cukier/Encoder/doc/atmega328p-pinout-4e8ab260.png

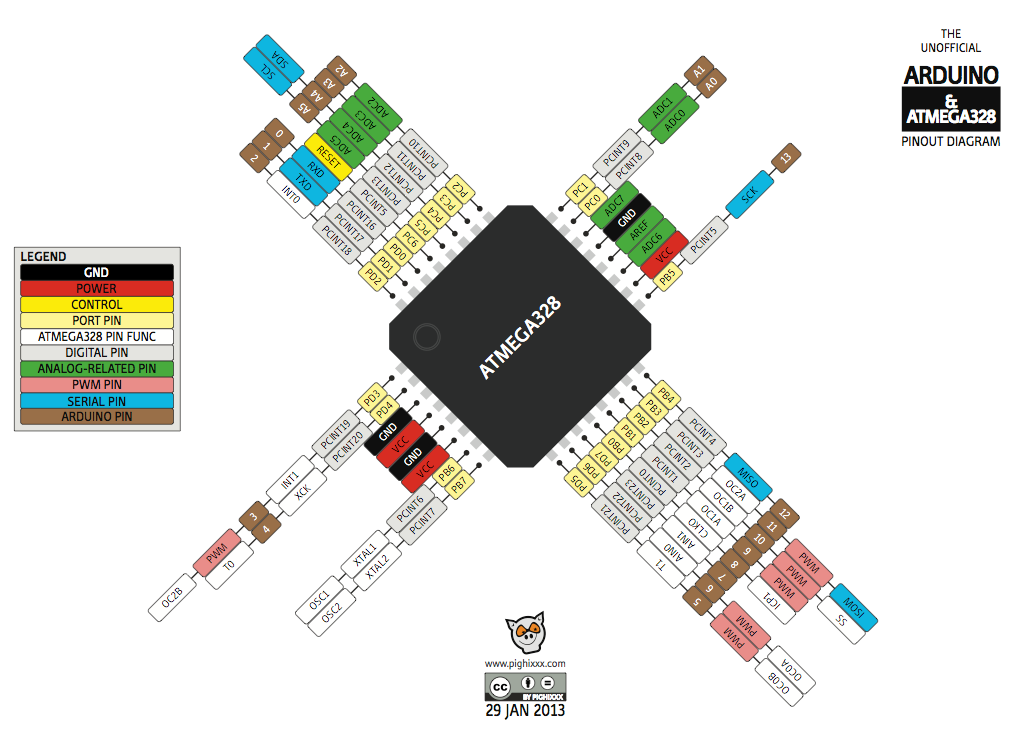
doc/atmega328p-pinout-4e8ab260.png
