cukier/Encoder/sch/atmel/pdf/encoder.pdf

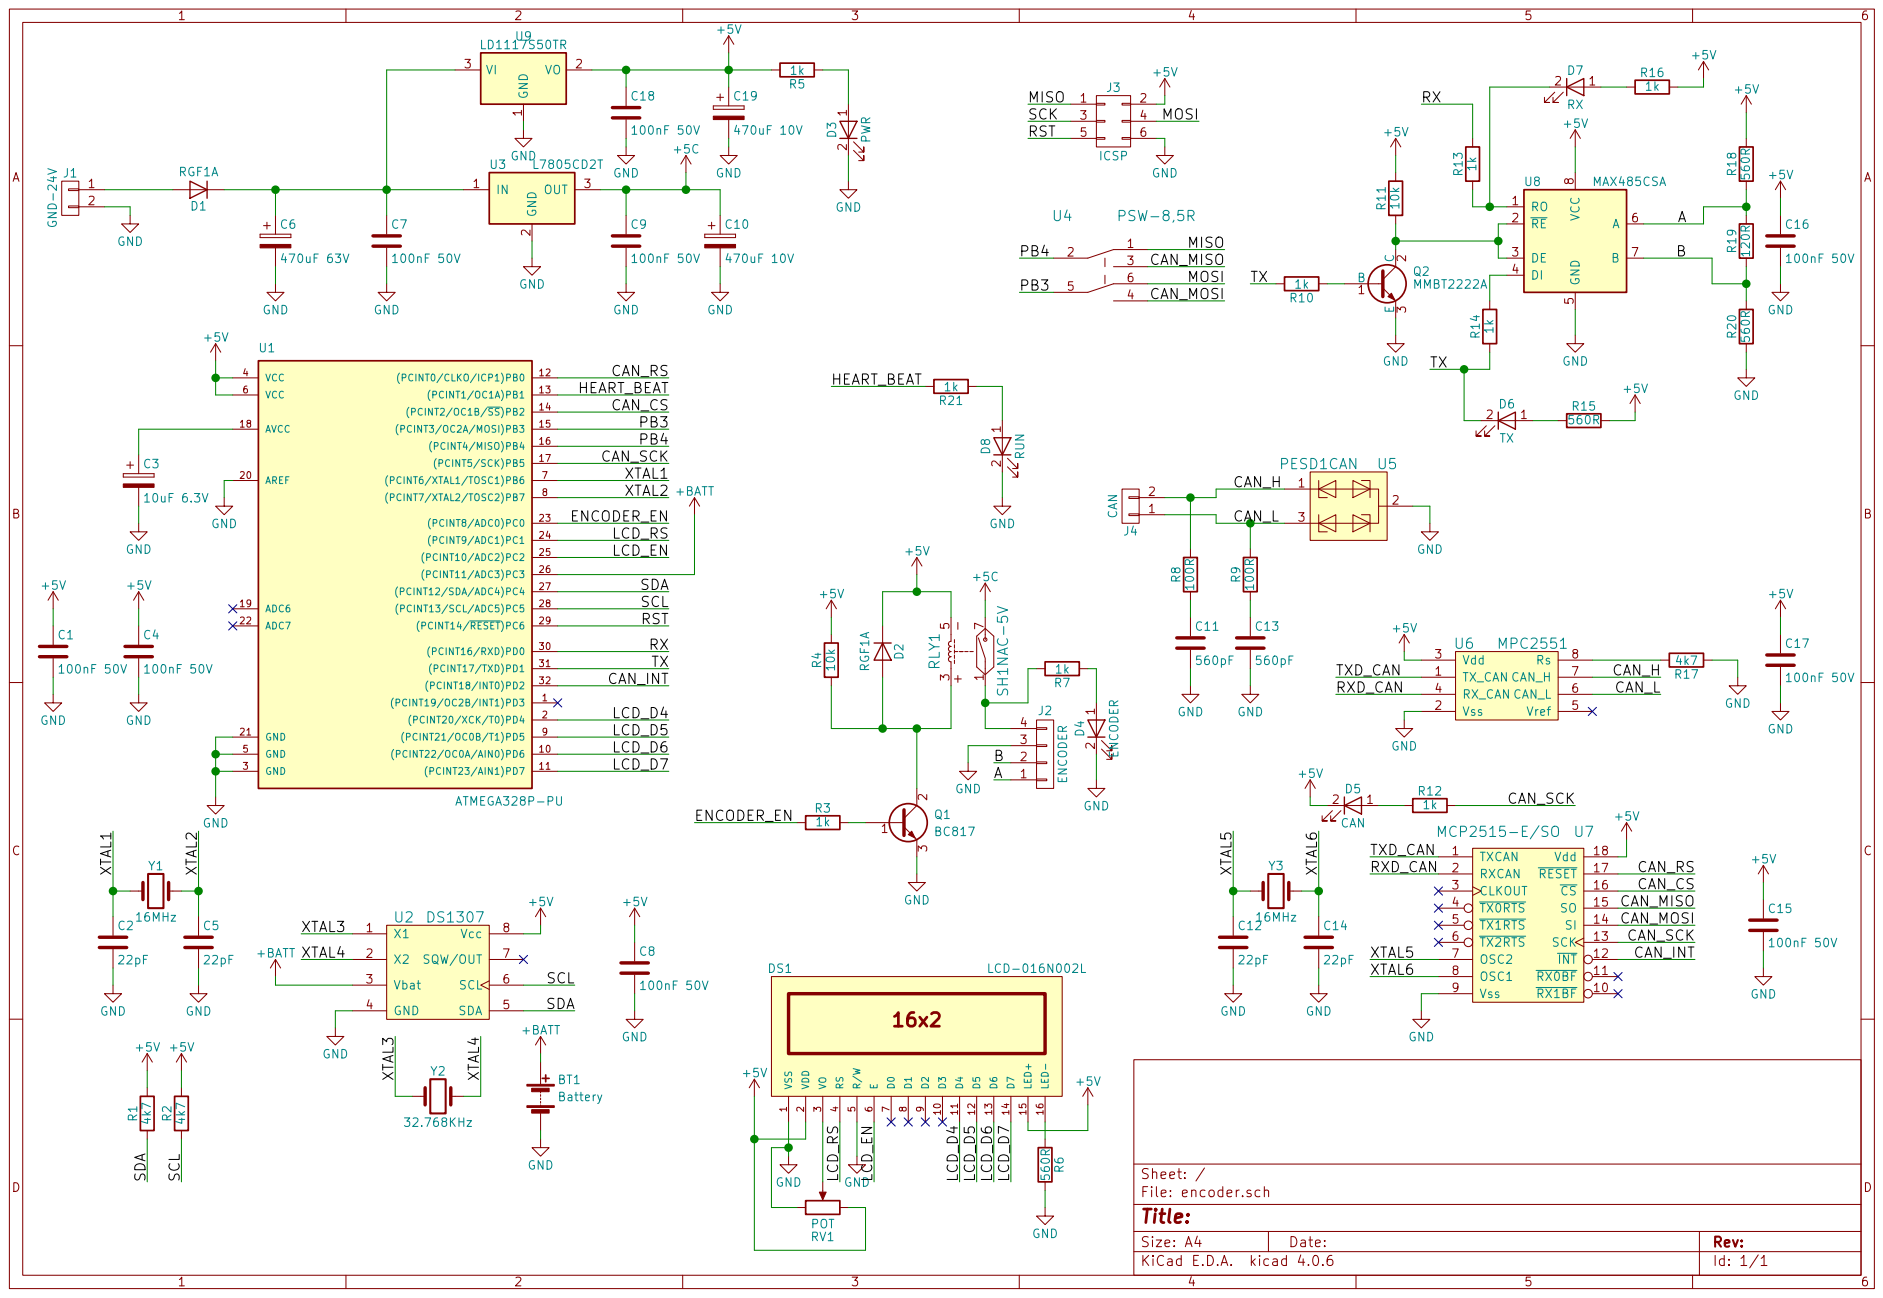
[picture p2: page 1]

9 D3 10 D4 11 D5 12 D6 13 D7 14 LED+ 15 LED- 16 DS1 LCD-016N002L GND

Id: 1/1 Title: File: encoder.sch Sheet: /
