cukier/Encoder/sch/microchip/doc/microchip-B.Cu.pdf

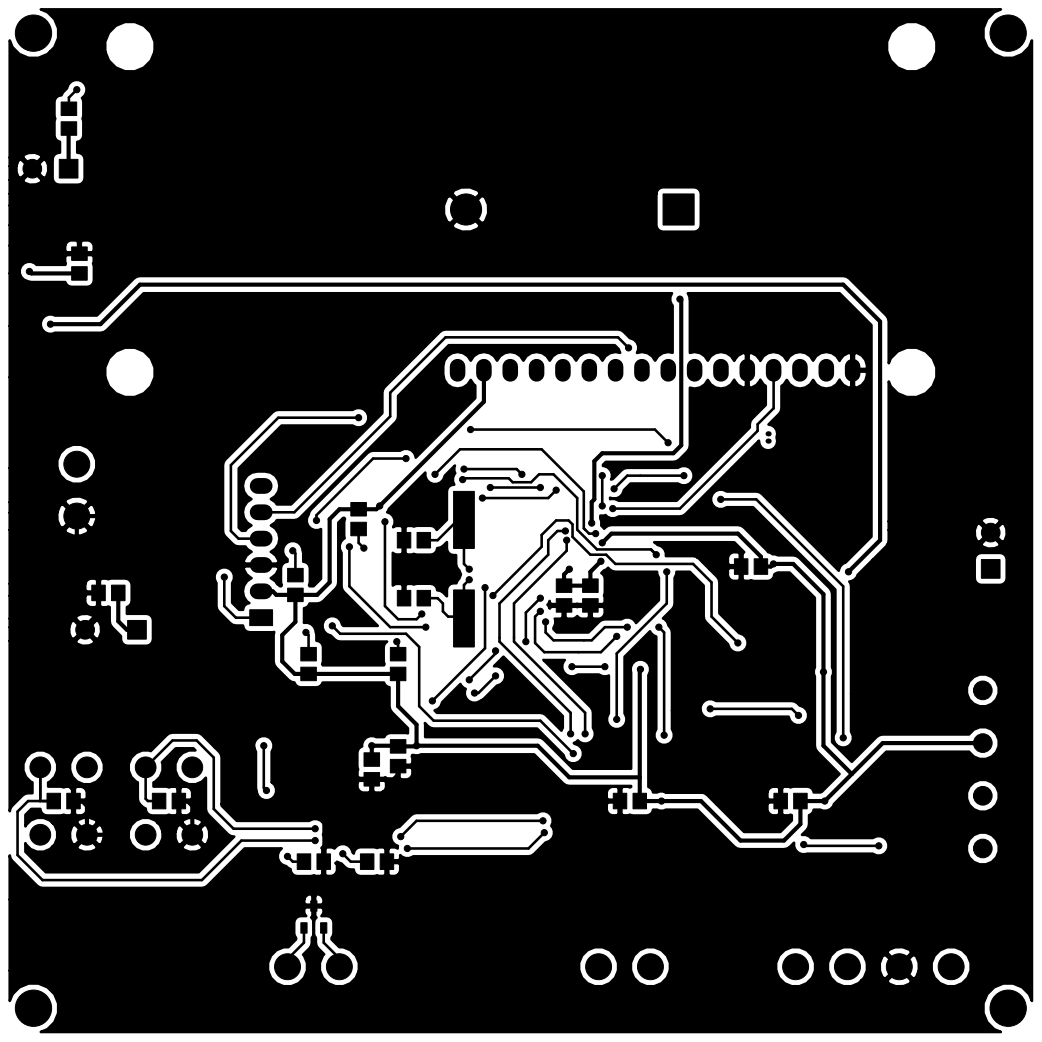
[picture p3: page 1]
