cukier/Encoder/sch/microchip/doc/microchip-B.Paste.pdf

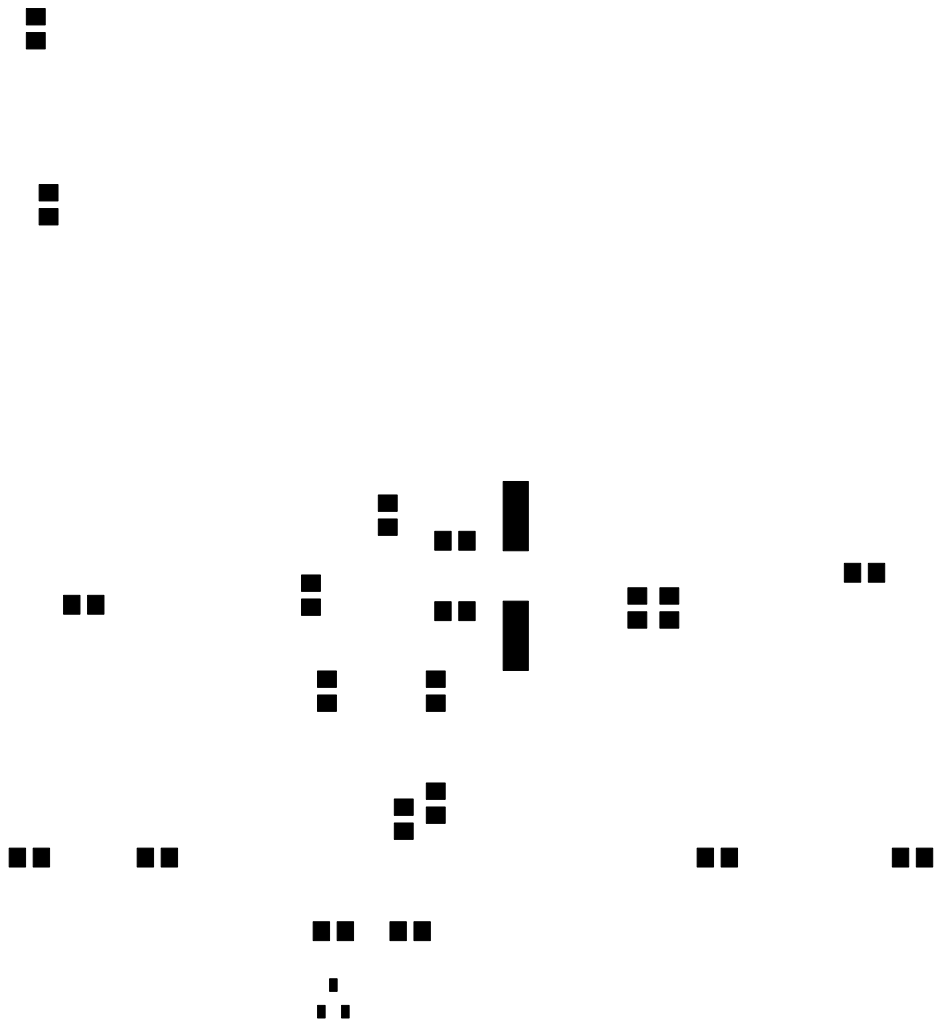
[picture p4: page 1]
