cukier/Encoder/sch/microchip/doc/microchip-B.SilkS.pdf

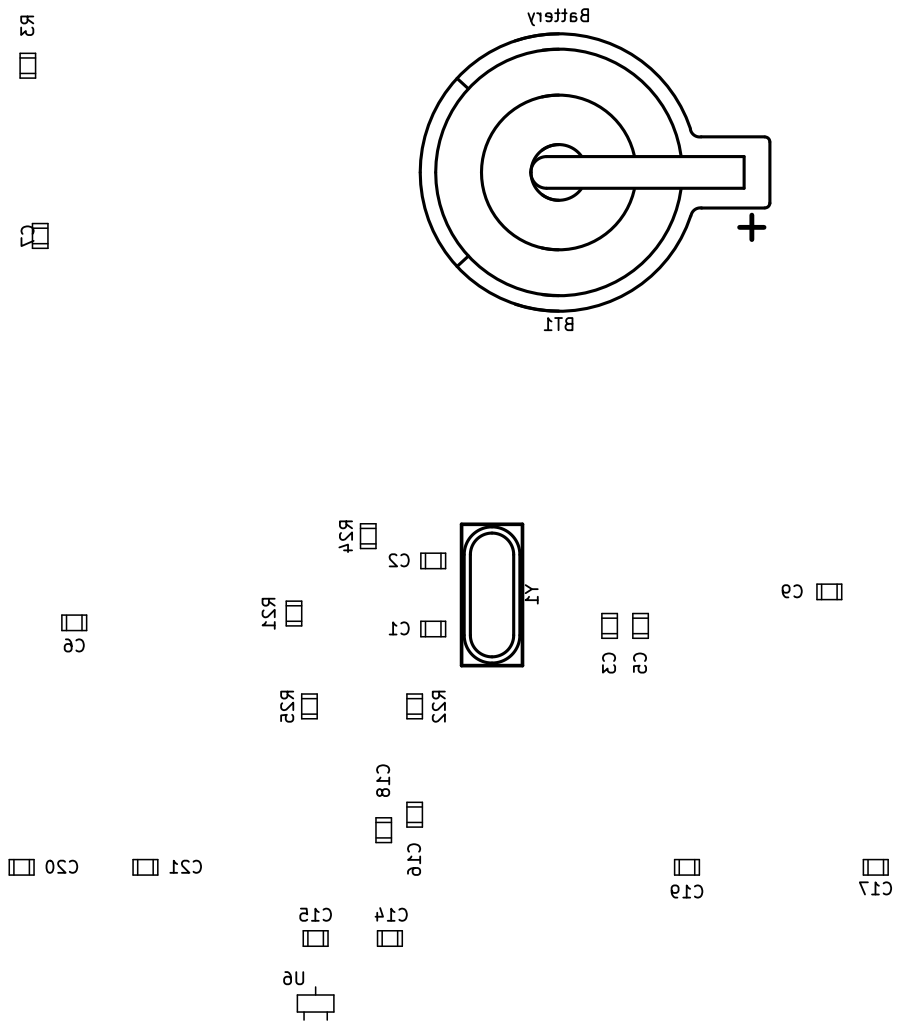
[picture p5: page 1]
