cukier/Encoder/sch/microchip/doc/microchip-F.Cu.pdf

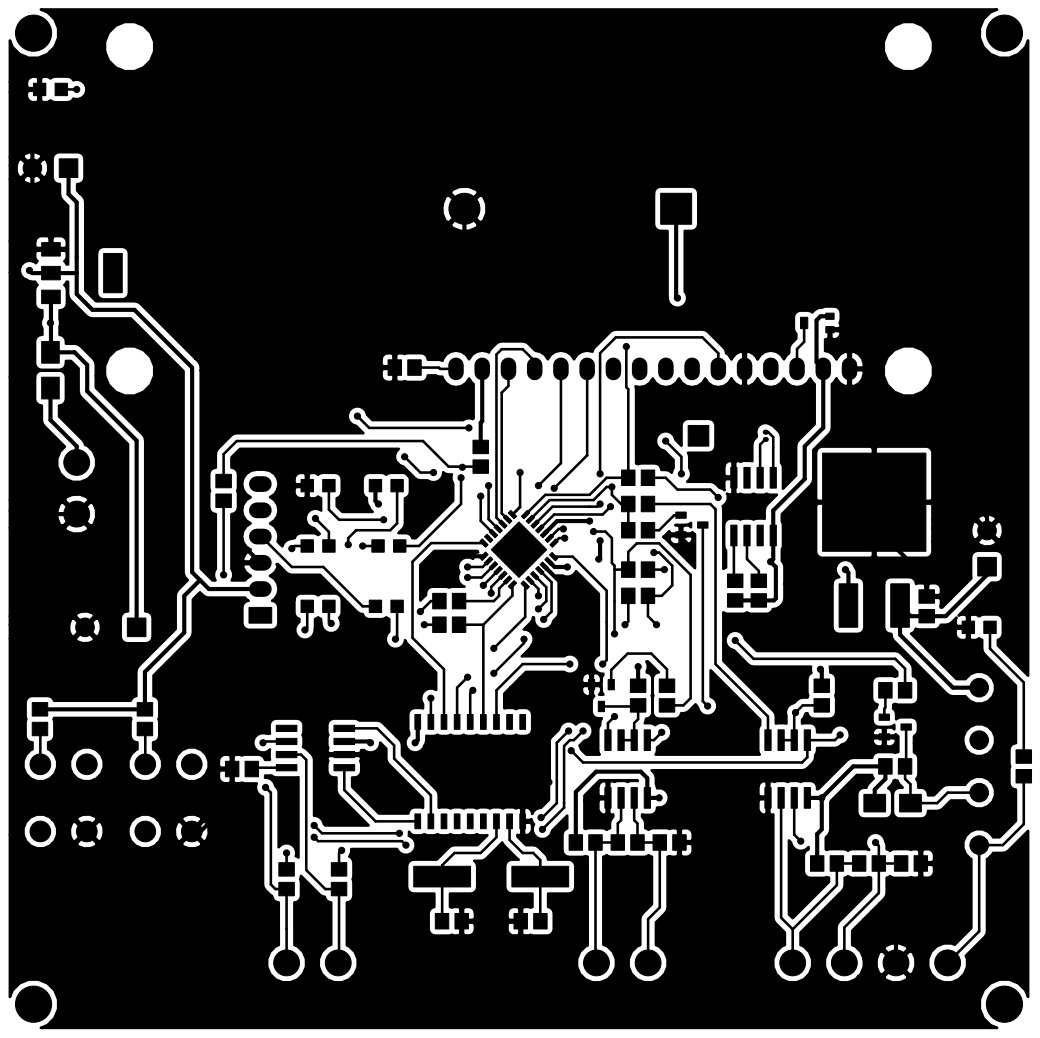
[picture p6: page 1]
