cukier/Encoder/sch/microchip/doc/microchip-F.Paste.pdf

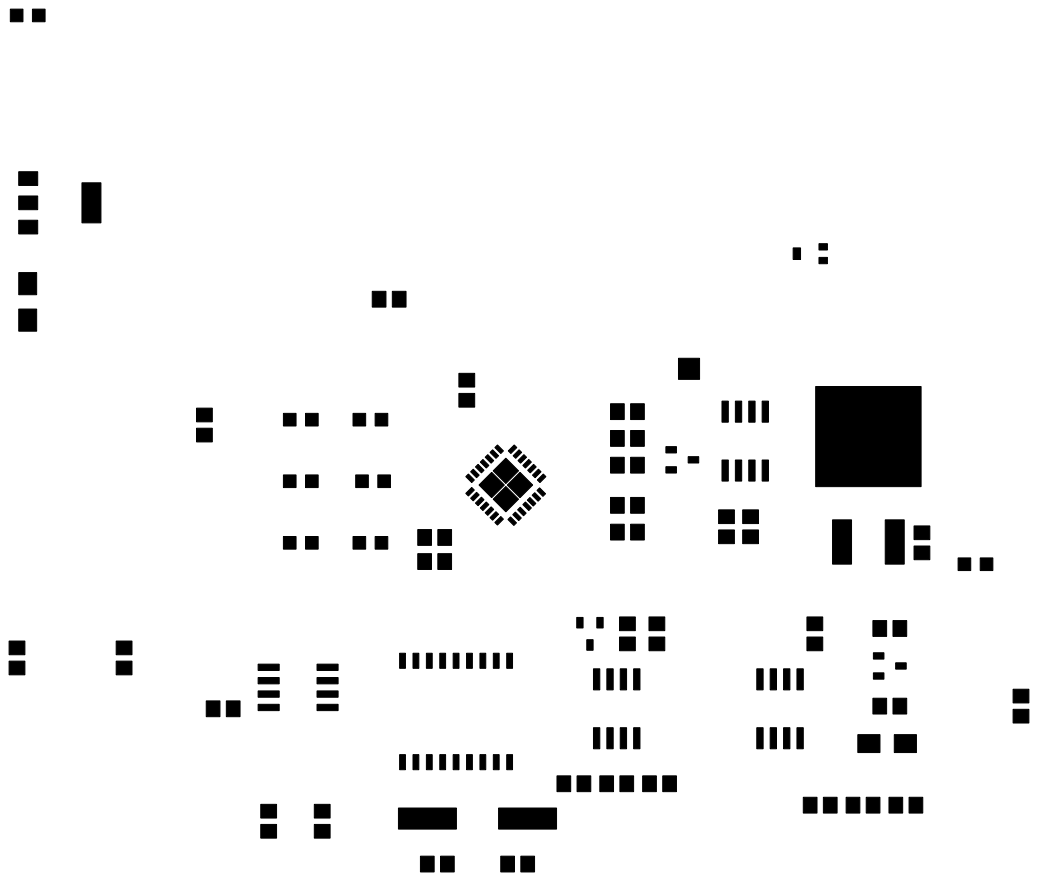
[picture p7: page 1]
