cukier/Encoder/sch/microchip/doc/microchip-F.SilkS.pdf

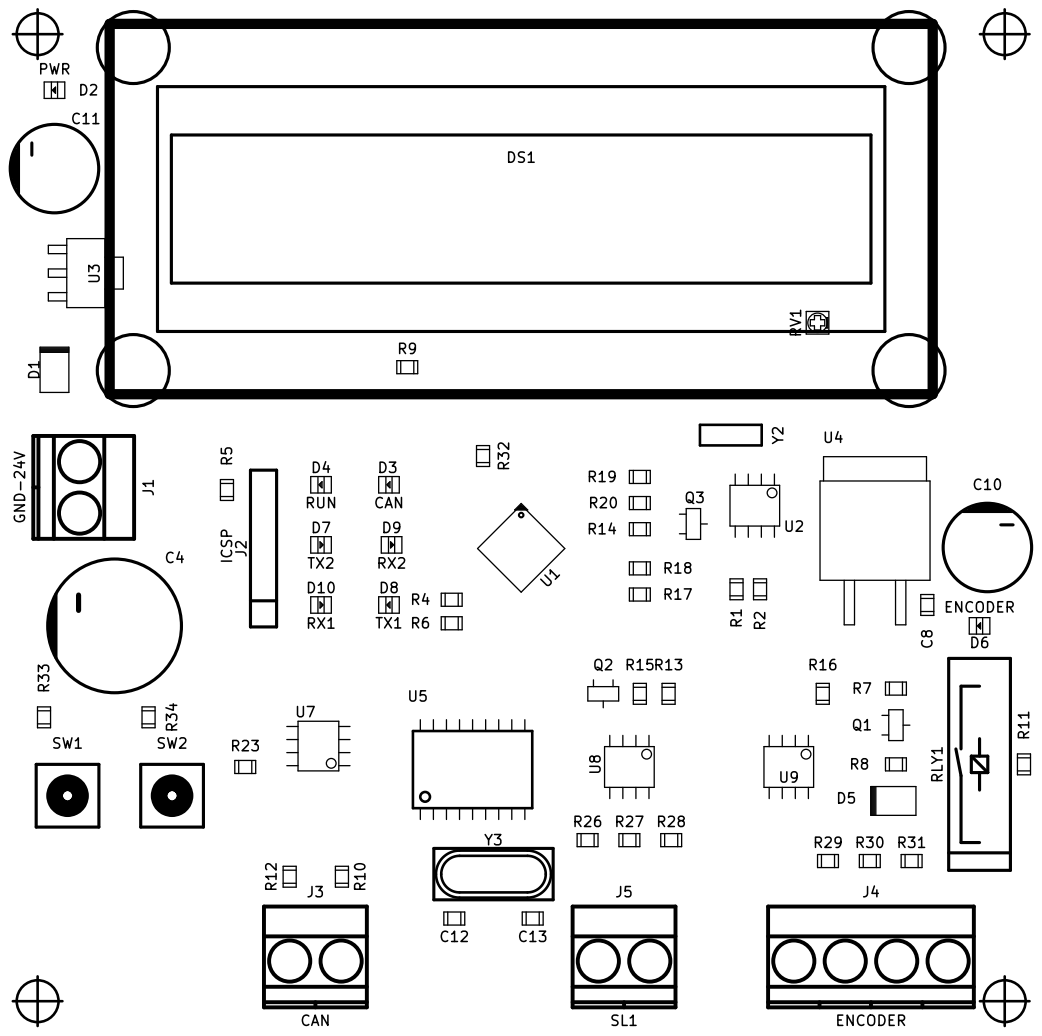
[picture p8: page 1]
