cukier/Encoder/sch/atmel/pdf/encoder-B.Cu.pdf

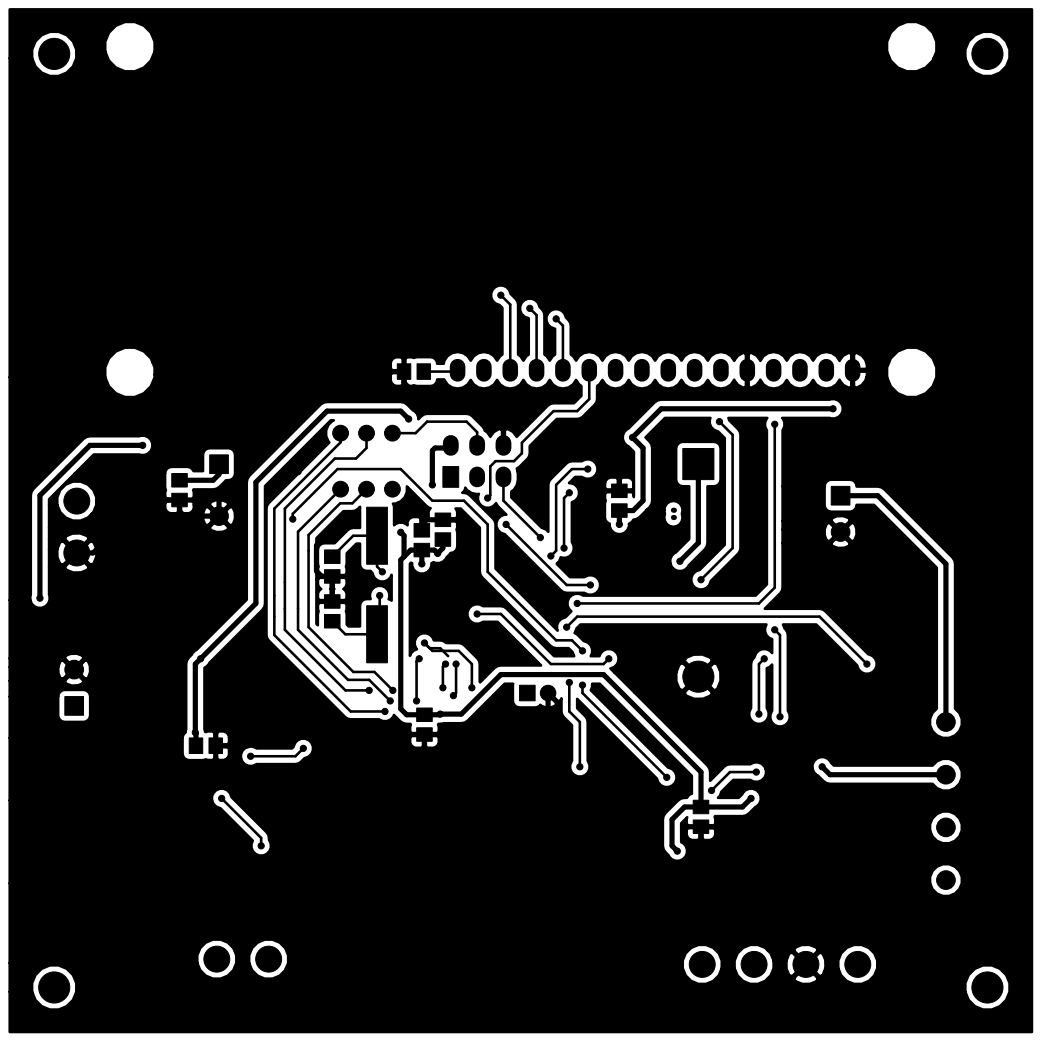
[picture p9: page 1]
