cukier/Encoder/sch/atmel/pdf/encoder-B.Mask.pdf

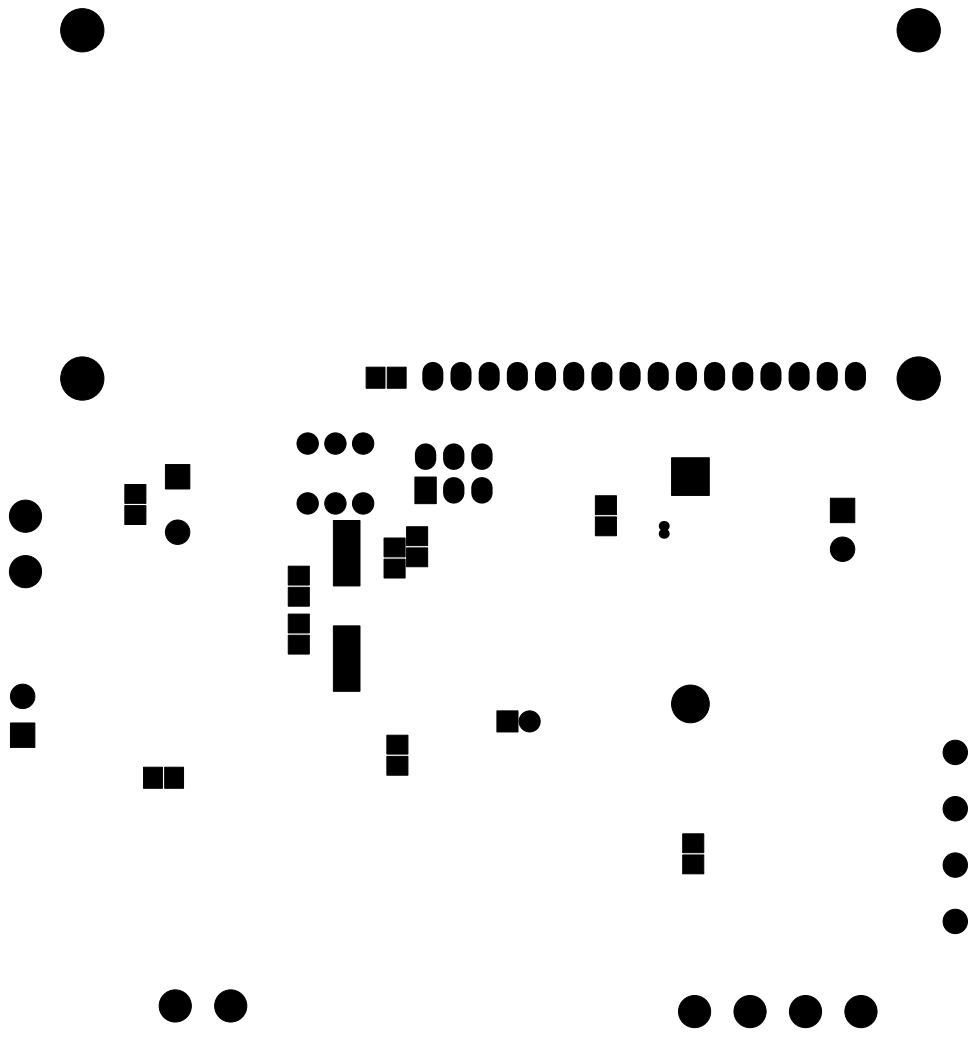
[picture p10: page 1]
