cukier/Encoder/sch/atmel/pdf/encoder-B.SilkS.pdf

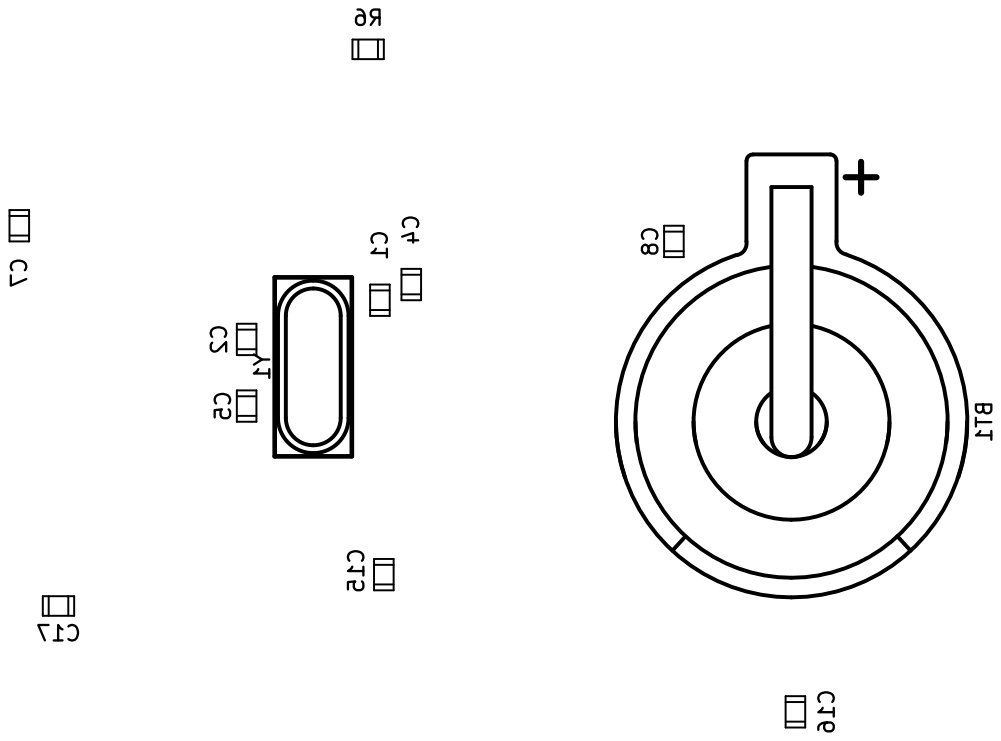
[picture p11: page 1]
