cukier/Encoder/sch/atmel/pdf/encoder-F.Cu.pdf

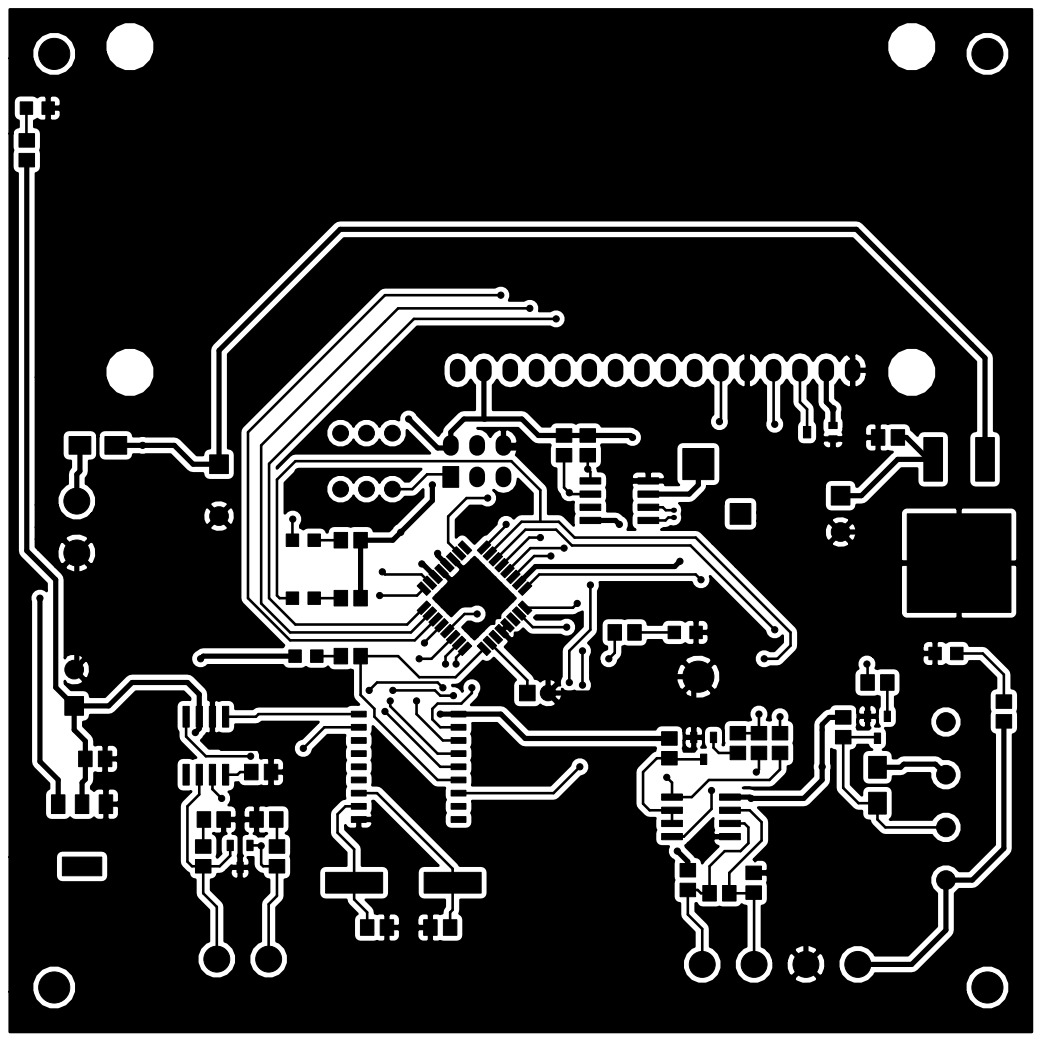
[picture p12: page 1]
