cukier/Encoder/sch/atmel/pdf/encoder-F.Mask.pdf

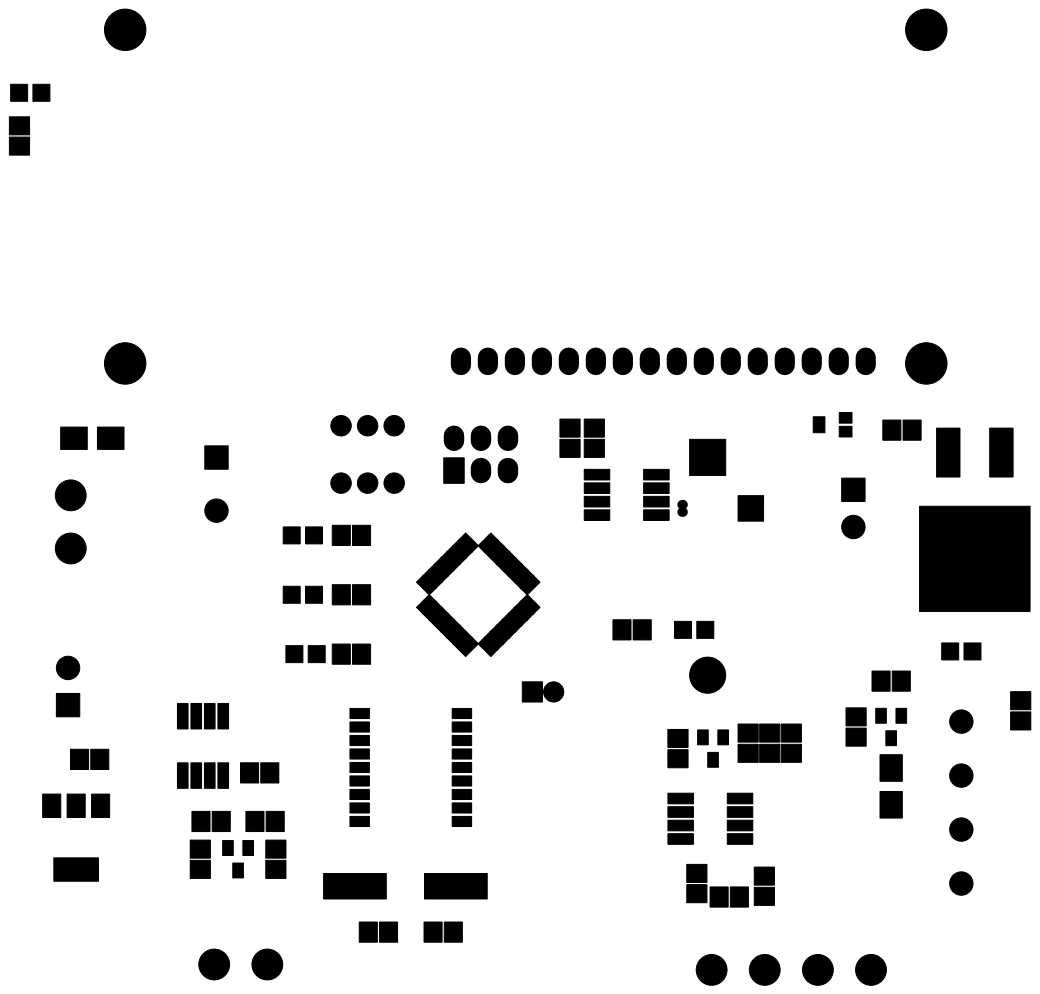
[picture p13: page 1]
