cukier/Encoder/sch/atmel/pdf/encoder-F.SilkS.pdf

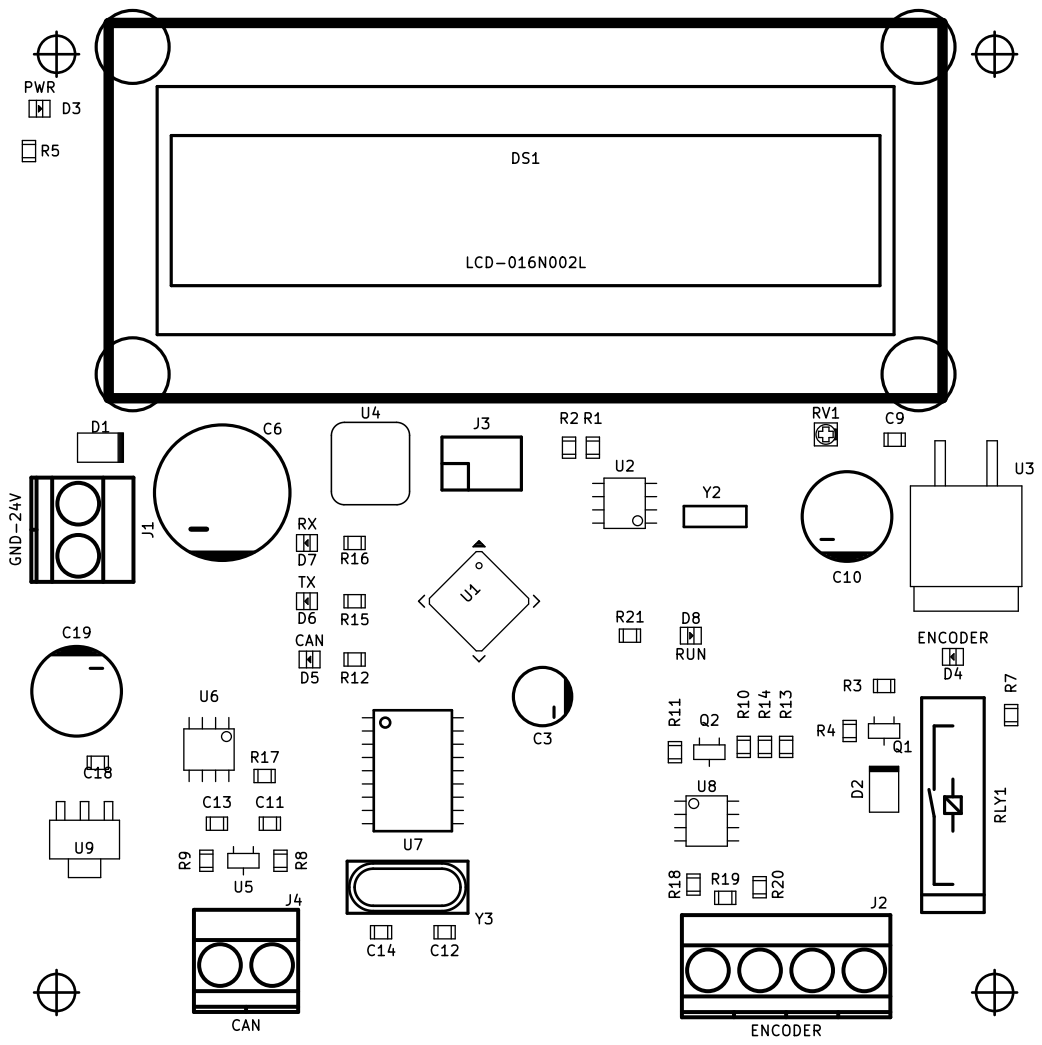
[picture p14: page 1]
