cukier/Encoder/(list of files, drawings)

Other design files:
sim/encoder.DSN
sim/encodera.DSN
