cukier/Encoder/sch/microchip/microchip.kicad_pcb

## KiCad design sch/microchip/microchip.kicad_pcb (2017-07-24)

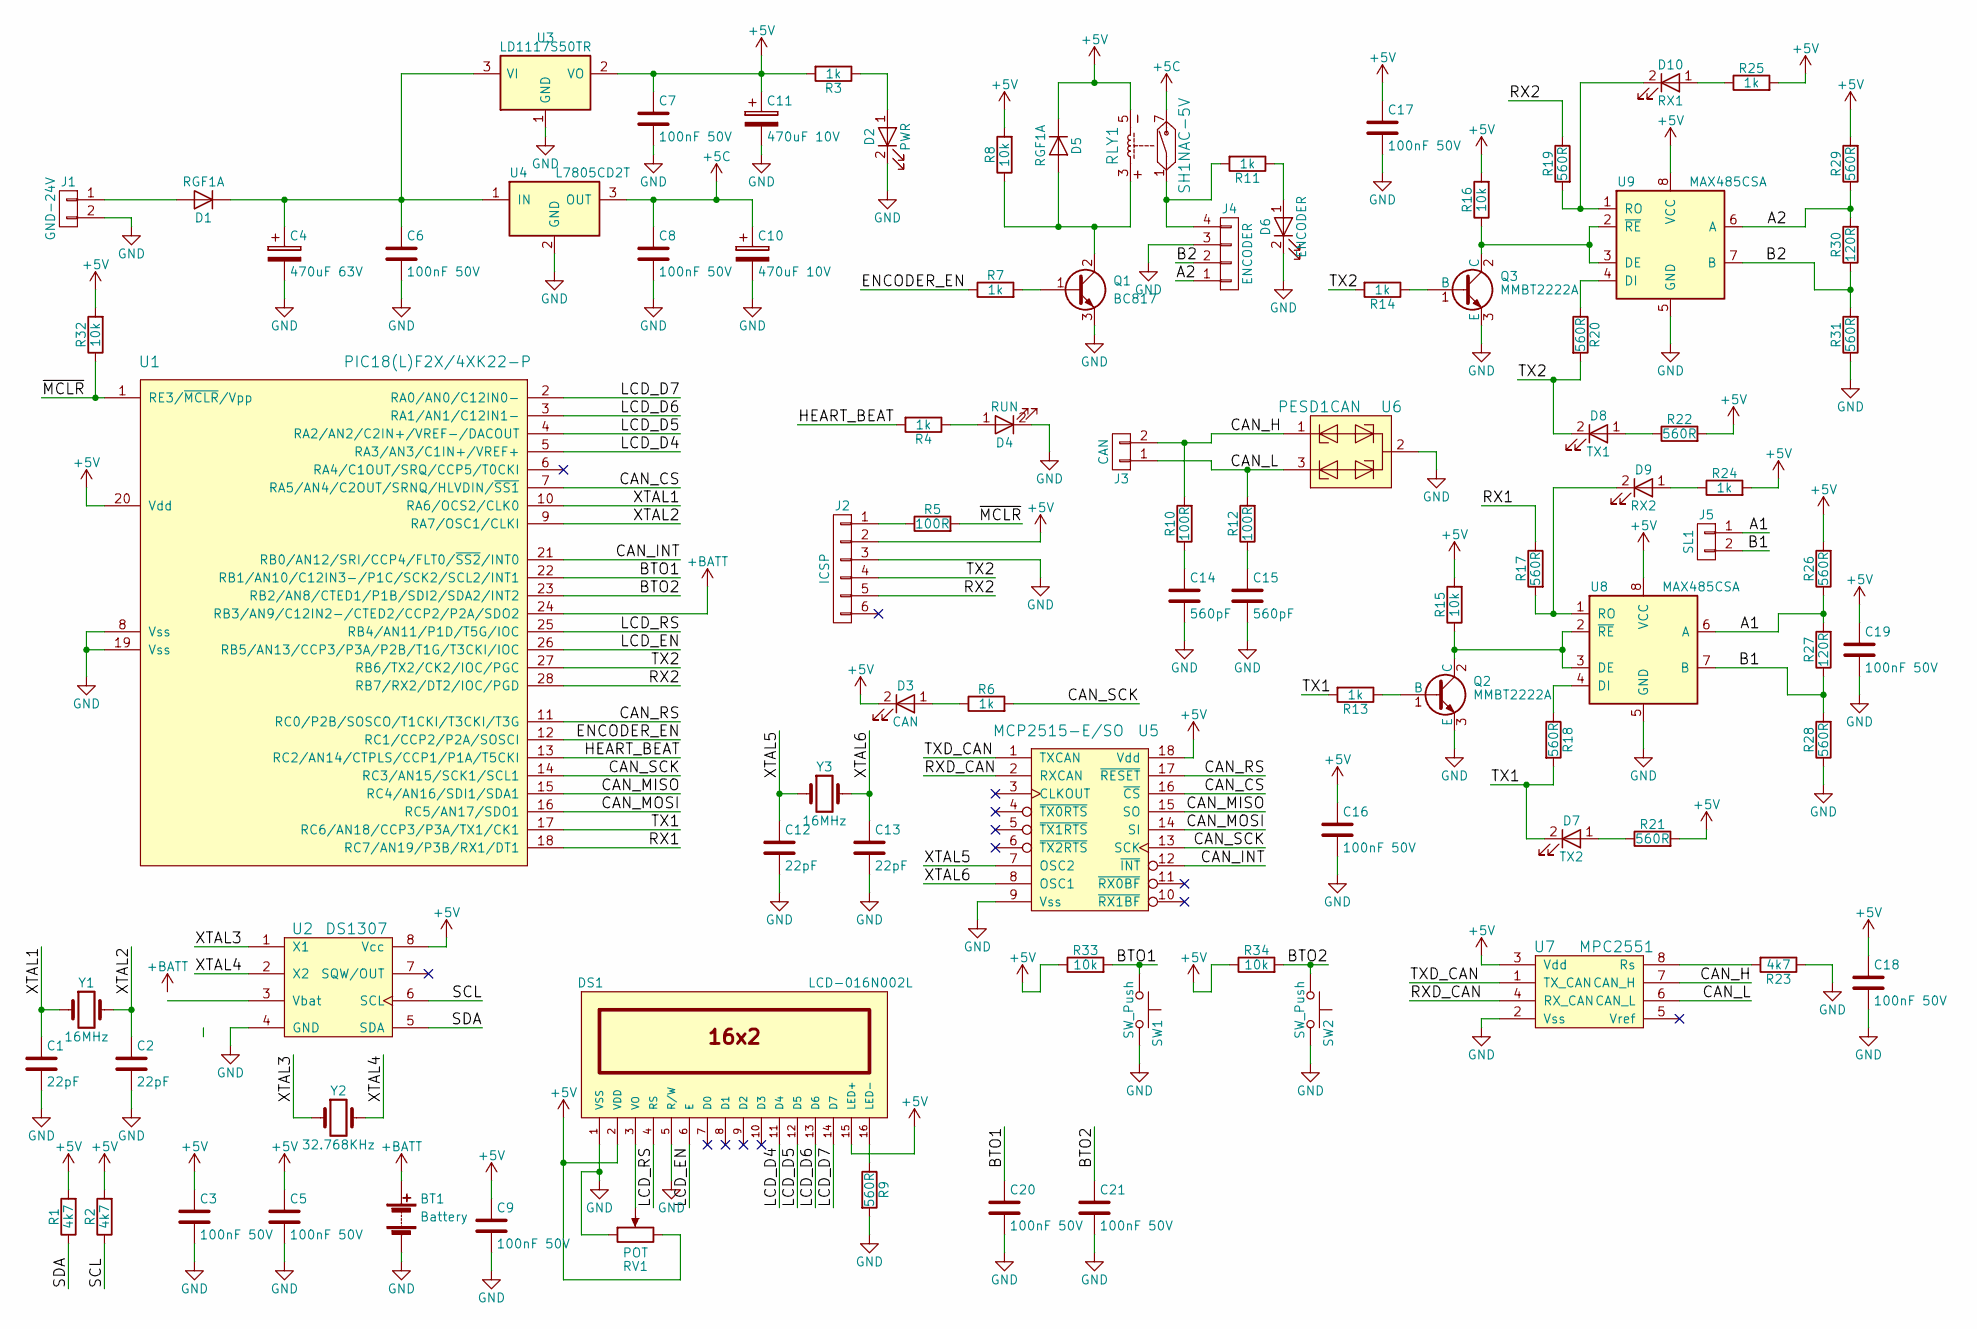
[picture p15: schematic microchip.sch]

Parts:
BT1: Battery; keystone_103
C1, C2, C12, C13: 22pF; c_0805
C3, C5, C6, C7, C8, C9, C16, C17, C18, C19, C20, C21: 100nF 50V; c_0805
C4: 470uF 63V; CP_12.5x25mm
C10, C11: 470uF 10V; CP_8x11.5mm
C14, C15: 560pF; c_0805
D1, D5: RGF1A; do214ac
D2: PWR; Led_0805
D3: CAN; Led_0805
D4: RUN; Led_0805
D6: ENCODER; Led_0805
D7: TX2; Led_0805
D8: TX1; Led_0805
D9: RX2; Led_0805
D10: RX1; Led_0805
DS1: LCD-016N002L; lcd_16x2
J1: GND-24V; mkds_1,5-2
J2: ICSP; pin_strip_6
J3: CAN; mkds_1,5-2
J4: ENCODER; mkds_1,5-4
J5: SL1; mkds_1,5-2
Q1: BC817; sot23
Q2, Q3: MMBT2222A; sot23
R1, R2, R23: 4k7; r_0805
R3, R4, R6, R7, R11, R13, R14, R24, R25: 1k; r_0805
R5, R10, R12: 100R; r_0805
R8, R15, R16, R32, R33, R34: 10k; r_0805
R9, R17, R18, R19, R20, R21, R22, R26, R28, R29, R31: 560R; r_0805
R27, R30: 120R; r_0805
RLY1: SH1NAC-5V; relay_9001
RV1: POT; trim_murata_pva2a
SW1, SW2: SW_Push; PCB_PUSH
U1: PIC18(L)F2X/4XK22-P; qfn-28
U2: DS1307; so-8
U3: LD1117S50TR; sot223
U4: L7805CD2T; d2-pak
U5: MCP2515-E/SO; soic-18
U6: PESD1CAN; sot23
U7: MPC2551; so-8
U8, U9: MAX485CSA; so-8
Y1, Y3: 16MHz; crystal_hc-49%2fsmd
Y2: 32.768KHz; crystal_tc-26_horiz

Connections:
+5C: C8.1, C10.1, RLY1.7, U4.3 (OUT)
+5V: C3.1, C5.1, C7.1, C9.1, C11.1, C16.1, C17.1, C18.1, C19.1, D3.2 (K), D5.2 (K), DS1.2 (VDD), DS1.15 (LED+), J2.2, R1.2, R2.2, R3.2, R8.2, R15.2, R16.2, R21.2, R22.2, R24.2, R25.2, R26.2, R29.2, R32.2, R33.1, R34.1, RLY1.5, RV1.3, U1.20 (Vdd), U2.8 (Vcc), U3.2 (VO), U5.18 (Vdd), U7.3 (Vdd), U8.8 (VCC), U9.8 (VCC)
+BATT: BT1.1 (+), U1.24 (RB3/AN9/C12IN2-/CTED2/CCP2/P2A/SDO2)
/A1: J5.1, R26.1, R27.2, U8.6 (A)
/A2: J4.1, R29.1, R30.2, U9.6 (A)
/B1: J5.2, R27.1, R28.2, U8.7 (B)
/B2: J4.2, R30.1, R31.2, U9.7 (B)
/BTO1: C20.1, R33.2, SW1.1, U1.22 (RB1/AN10/C12IN3-/P1C/SCK2/SCL2/INT1)
/BTO2: C21.1, R34.2, SW2.1, U1.23 (RB2/AN8/CTED1/P1B/SDI2/SDA2/INT2)
/CAN_CS: U1.7 (RA5/AN4/C2OUT/SRNQ/HLVDIN/~SS1), U5.16 (~CS)
/CAN_H: J3.2, R10.2, U6.1, U7.7 (CAN_H)
/CAN_INT: U1.21 (RB0/AN12/SRI/CCP4/FLT0/~SS2~/INT0), U5.12 (~INT)
/CAN_L: J3.1, R12.2, U6.3, U7.6 (CAN_L)
/CAN_MISO: U1.15 (RC4/AN16/SDI1/SDA1), U5.15 (SO)
/CAN_MOSI: U1.16 (RC5/AN17/SDO1), U5.14 (SI)
/CAN_RS: U1.11 (RC0/P2B/SOSCO/T1CKI/T3CKI/T3G), U5.17 (~RESET)
/CAN_SCK: R6.2, U1.14 (RC3/AN15/SCK1/SCL1), U5.13 (SCK)
/ENCODER_EN: R7.1, U1.12 (RC1/CCP2/P2A/SOSCI)
/HEART_BEAT: R4.2, U1.13 (RC2/AN14/CTPLS/CCP1/P1A/T5CKI)
/LCD_D4: DS1.11 (D4), U1.5 (RA3/AN3/C1IN+/VREF+)
/LCD_D5: DS1.12 (D5), U1.4 (RA2/AN2/C2IN+/VREF-/DACOUT)
/LCD_D6: DS1.13 (D6), U1.3 (RA1/AN1/C12IN1-)
/LCD_D7: DS1.14 (D7), U1.2 (RA0/AN0/C12IN0-)
/LCD_EN: DS1.6 (E), U1.26 (RB5/AN13/CCP3/P3A/P2B/T1G/T3CKI/IOC)
/LCD_RS: DS1.4 (RS), U1.25 (RB4/AN11/P1D/T5G/IOC)
/RX1: R17.1, U1.18 (RC7/AN19/P3B/RX1/DT1)
/RX2: J2.5, R19.1, U1.28 (RB7/RX2/DT2/IOC/PGD)
/RXD_CAN: U5.2 (RXCAN), U7.4 (RX_CAN)
/SCL: R2.1, U2.6 (SCL)
/SDA: R1.1, U2.5 (SDA)
/TX1: D7.2 (K), R13.2, R18.2, U1.17 (RC6/AN18/CCP3/P3A/TX1/CK1)
/TX2: D8.2 (K), J2.4, R14.2, R20.2, U1.27 (RB6/TX2/CK2/IOC/PGC)
/TXD_CAN: U5.1 (TXCAN), U7.1 (TX_CAN)
/XTAL1: C1.1, U1.10 (RA6/OCS2/CLK0), Y1.1
/XTAL2: C2.1, U1.9 (RA7/OSC1/CLKI), Y1.2
/XTAL3: U2.1 (X1), Y2.1
/XTAL4: U2.2 (X2), Y2.2
/XTAL5: C12.1, U5.7 (OSC2), Y3.1
/XTAL6: C13.1, U5.8 (OSC1), Y3.2
/~MCLR: R5.2, R32.1, U1.1 (RE3/~MCLR~/Vpp)
GND: BT1.2 (-), C1.2, C2.2, C3.2, C4.2, C5.2, C6.2, C7.2, C8.2, C9.2, C10.2, C11.2, C12.2, C13.2, C14.2, C15.2, C16.2, C17.2, C18.2, C19.2, C20.2, C21.2, D2.2 (K), D4.2 (K), D6.2 (K), DS1.1 (VSS), DS1.5 (R/W), J1.2, J2.3, J4.3, Q1.3 (E), Q2.3 (E), Q3.3 (E), R9.2, R23.1, R28.1, R31.1, RV1.1, SW1.2, SW2.2, U1.8 (Vss), U1.19 (Vss), U2.4 (GND), U3.1 (GND), U4.2 (GND), U5.9 (Vss), U6.2, U7.2 (Vss), U8.5 (GND), U9.5 (GND)
unnamed: C4.1, C6.1, D1.2 (K), U3.3 (VI), U4.1 (IN)
unnamed: C14.1, R10.1
unnamed: C15.1, R12.1
unnamed: D1.1 (A), J1.1
unnamed: D2.1 (A), R3.1
unnamed: D3.1 (A), R6.1
unnamed: D4.1 (A), R4.1
unnamed: D5.1 (A), Q1.2 (C), R8.1, RLY1.3
unnamed: D6.1 (A), R11.1
unnamed: D7.1 (A), R21.1
unnamed: D8.1 (A), R22.1
unnamed: D9.1 (A), R24.1
unnamed: D9.2 (K), R17.2, U8.1 (RO)
unnamed: D10.1 (A), R25.1
unnamed: D10.2 (K), R19.2, U9.1 (RO)
unnamed: DS1.3 (VO), RV1.2
unnamed: DS1.16 (LED-), R9.1
unnamed: J2.1, R5.1
unnamed: J4.4, R11.2, RLY1.1
unnamed: Q1.1 (B), R7.2
unnamed: Q2.1 (B), R13.1
unnamed: Q2.2 (C), R15.1, U8.2 (~RE~), U8.3 (DE)
unnamed: Q3.1 (B), R14.1
unnamed: Q3.2 (C), R16.1, U9.2 (~RE~), U9.3 (DE)
unnamed: R18.1, U8.4 (DI)
unnamed: R20.1, U9.4 (DI)
unnamed: R23.2, U7.8 (Rs)

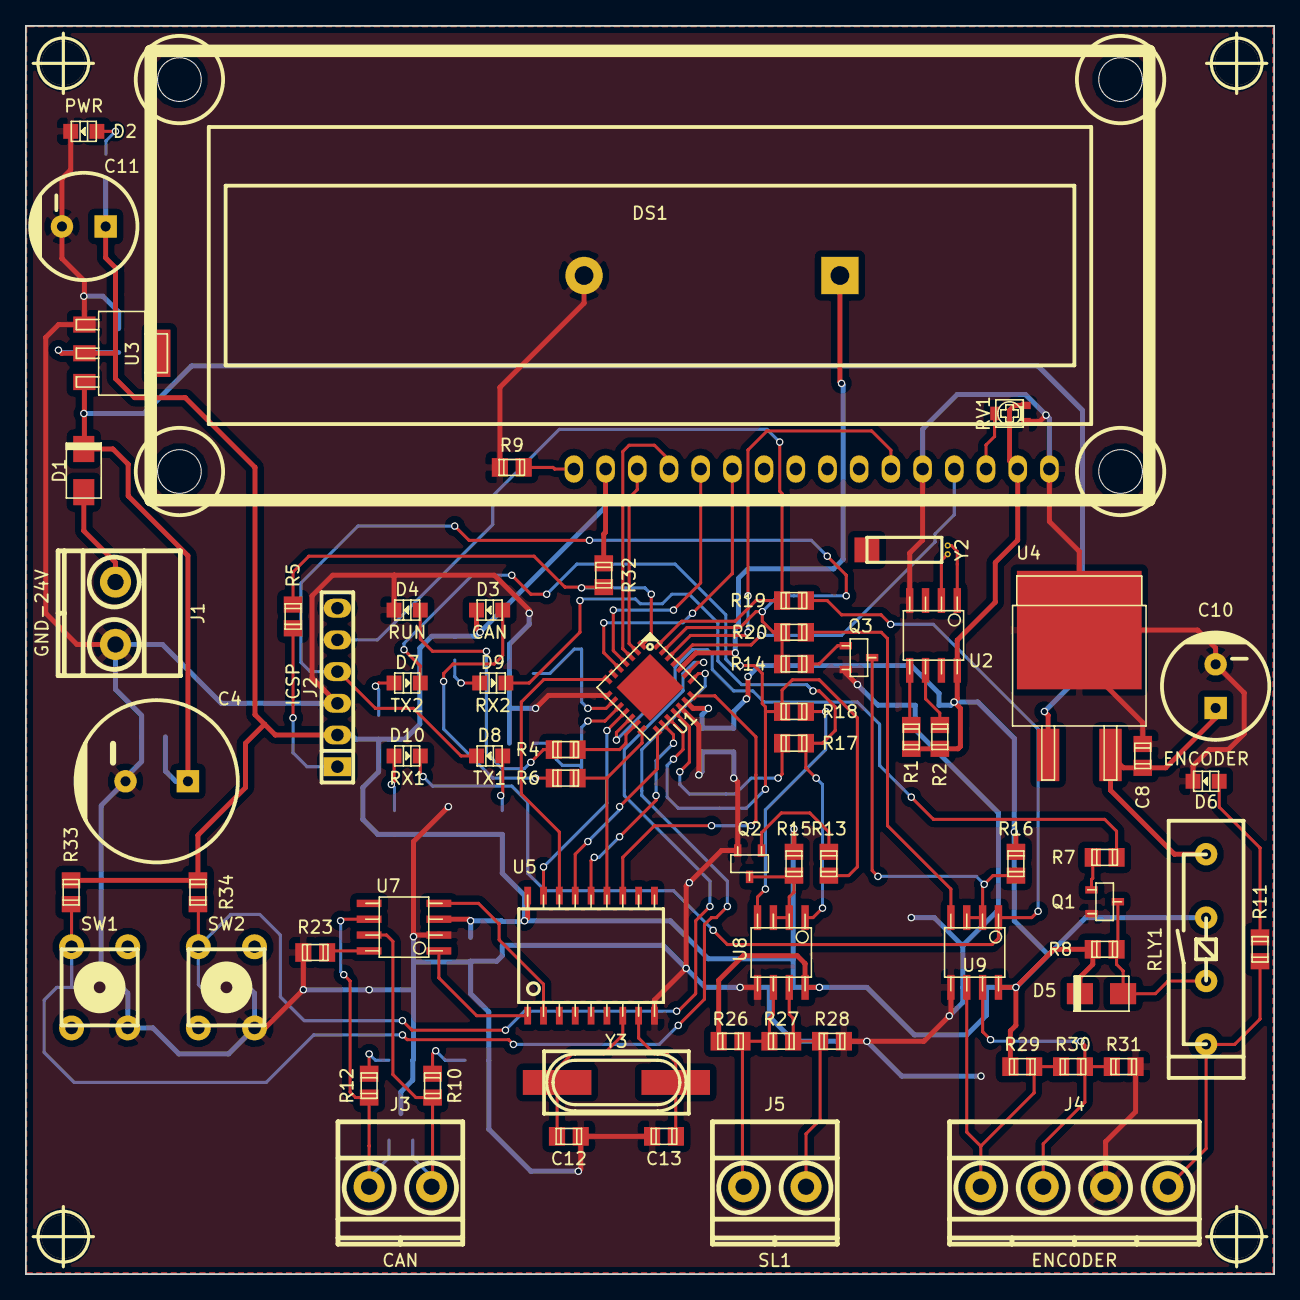
[picture p16: board microchip.kicad_pcb from above]

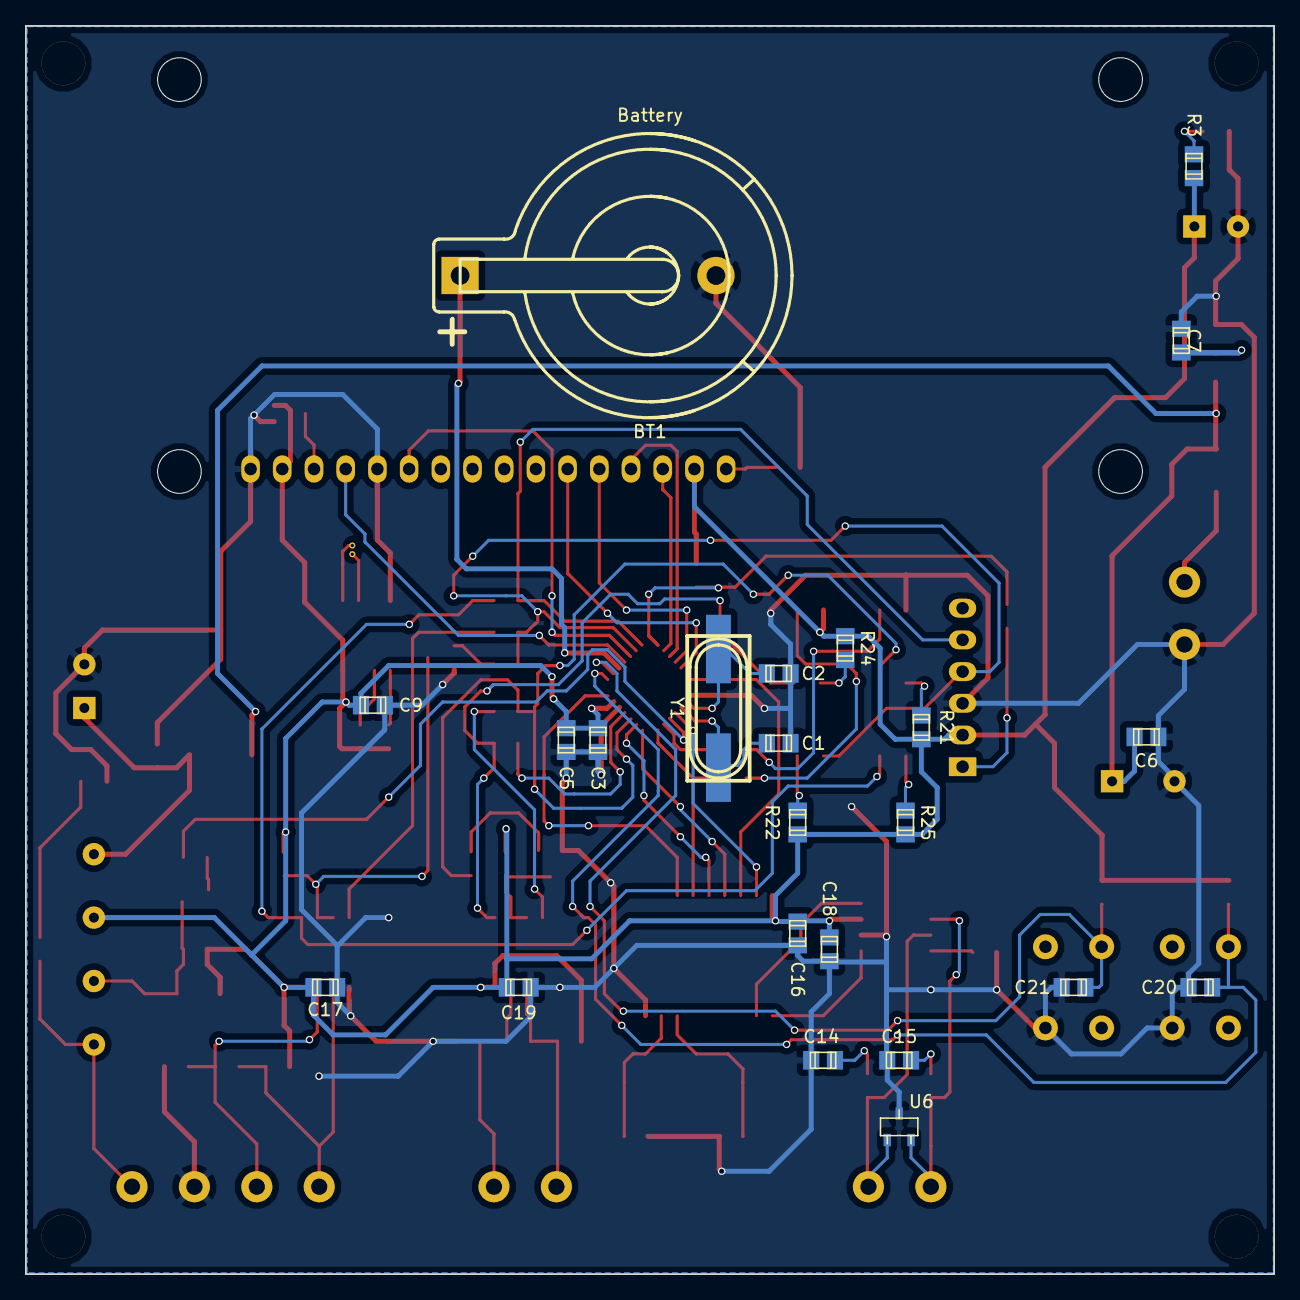
[picture p17: board microchip.kicad_pcb from below]

Board: 2 copper layers, 100.0 x 100.0 mm, 95 parts (23 on the bottom side), 68 nets.

Other parts of the board:
hole_3mm5, hole_3mm5#2, hole_3mm5#3, hole_3mm5#4: VAL**; hole_3mm5
