cukier/Encoder/sch/atmel/encoder.kicad_pcb

## KiCad design sch/atmel/encoder.kicad_pcb (2017-07-06)

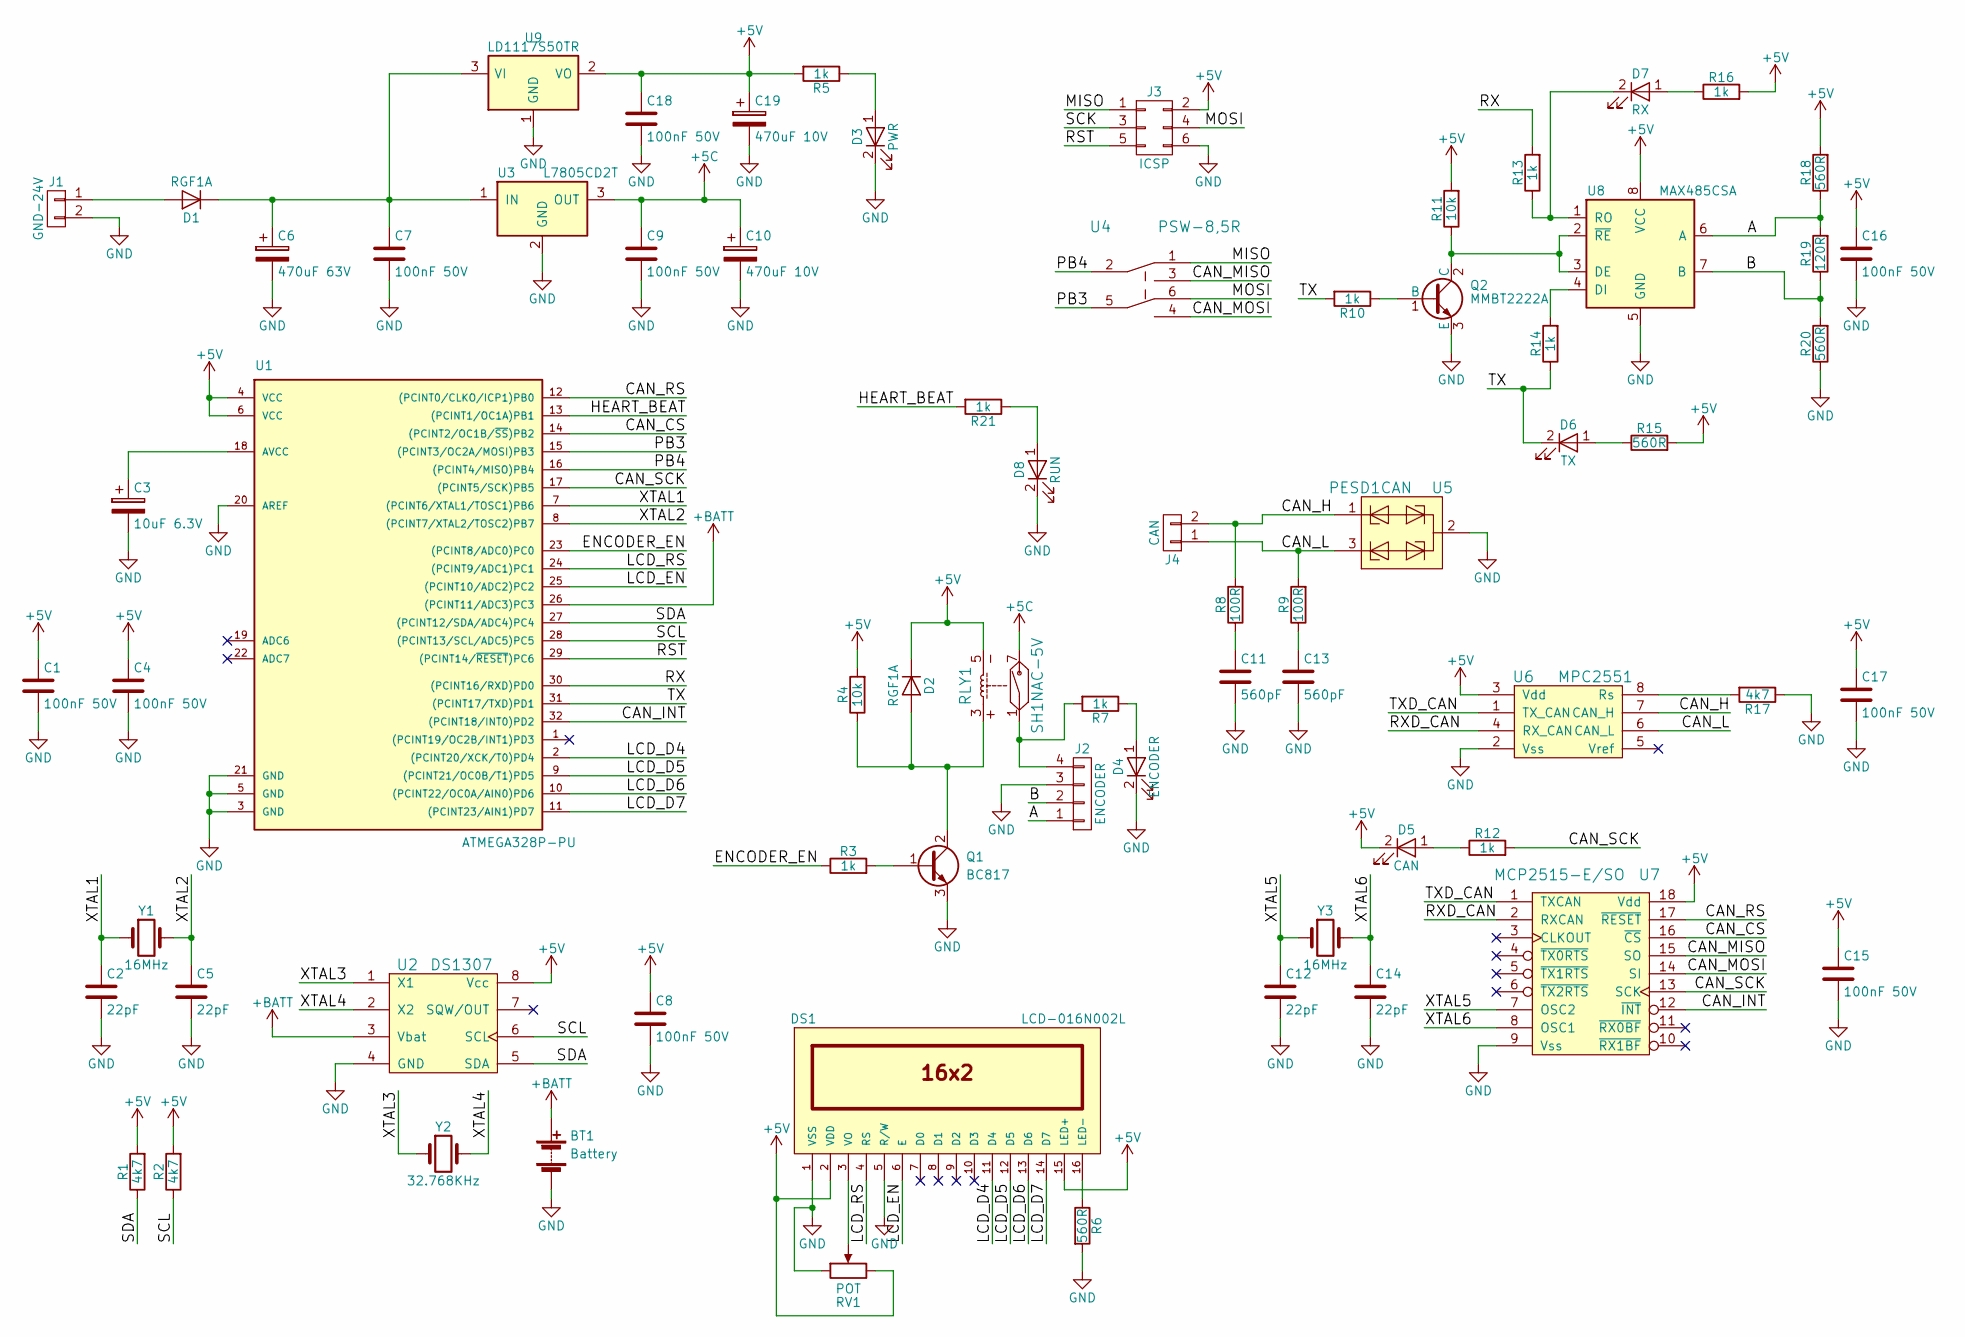
[picture p18: schematic encoder.sch]

Parts:
BT1: Battery; keystone_103
C1, C4, C7, C8, C9, C15, C16, C17, C18: 100nF 50V; c_0805
C2, C5, C12, C14: 22pF; c_0805
C3: 10uF 6.3V; CP_5x11mm
C6: 470uF 63V; CP_12.5x25mm
C10, C19: 470uF 10V; CP_8x11.5mm
C11, C13: 560pF; c_0805
D1, D2: RGF1A; do214ac
D3: PWR; Led_0805
D4: ENCODER; Led_0805
D5: CAN; Led_0805
D6: TX; Led_0805
D7: RX; Led_0805
D8: RUN; Led_0805
DS1: LCD-016N002L; lcd_16x2
J1: GND-24V; mkds_1,5-2
J2: ENCODER; mkds_1,5-4
J3: ICSP; pin_strip_3x2
J4: CAN; mkds_1,5-2
Q1: BC817; sot23
Q2: MMBT2222A; sot23
R1, R2, R17: 4k7; r_0805
R3, R5, R7, R10, R12, R13, R14, R16, R21: 1k; r_0805
R4, R11: 10k; r_0805
R6, R15, R18, R20: 560R; r_0805
R8, R9: 100R; r_0805
R19: 120R; r_0805
RLY1: SH1NAC-5V; relay_9001
RV1: POT; trim_murata_pva2a
U1: ATMEGA328P-PU; lqfp32
U2: DS1307; so-8
U3: L7805CD2T; d2-pak
U4: PSW-8,5R; psw-8,5
U5: PESD1CAN; sot23
U6: MPC2551; so-8
U7: MCP2515-E/SO; soic-18
U8: MAX485CSA; so-8
U9: LD1117S50TR; sot223
Y1, Y3: 16MHz; crystal_hc-49%2fsmd
Y2: 32.768KHz; crystal_tc-26_horiz

Connections:
+5C: C9.1, C10.1, RLY1.7, U3.3 (OUT)
+5V: C1.1, C4.1, C8.1, C15.1, C16.1, C17.1, C18.1, C19.1, D2.2 (K), D5.2 (K), DS1.2 (VDD), DS1.15 (LED+), J3.2, R1.2, R2.2, R4.2, R5.2, R11.2, R15.2, R16.2, R18.2, RLY1.5, RV1.3, U1.4 (VCC), U1.6 (VCC), U2.8 (Vcc), U6.3 (Vdd), U7.18 (Vdd), U8.8 (VCC), U9.2 (VO)
+BATT: BT1.1 (+), U1.26 ((PCINT11/ADC3)PC3), U2.3 (Vbat)
/A: J2.1, R18.1, R19.2, U8.6 (A)
/B: J2.2, R19.1, R20.2, U8.7 (B)
/CAN_CS: U1.14 ((PCINT2/OC1B/~SS~)PB2), U7.16 (~CS)
/CAN_H: J4.2, R8.2, U5.1, U6.7 (CAN_H)
/CAN_INT: U1.32 ((PCINT18/INT0)PD2), U7.12 (~INT)
/CAN_L: J4.1, R9.2, U5.3, U6.6 (CAN_L)
/CAN_MISO: U4.3, U7.15 (SO)
/CAN_MOSI: U4.4, U7.14 (SI)
/CAN_RS: U1.12 ((PCINT0/CLKO/ICP1)PB0), U7.17 (~RESET)
/CAN_SCK: R12.2, U1.17 ((PCINT5/SCK)PB5), U7.13 (SCK)
/ENCODER_EN: R3.1, U1.23 ((PCINT8/ADC0)PC0)
/HEART_BEAT: R21.2, U1.13 ((PCINT1/OC1A)PB1)
/LCD_D4: DS1.11 (D4), U1.2 ((PCINT20/XCK/T0)PD4)
/LCD_D5: DS1.12 (D5), U1.9 ((PCINT21/OC0B/T1)PD5)
/LCD_D6: DS1.13 (D6), U1.10 ((PCINT22/OC0A/AIN0)PD6)
/LCD_D7: DS1.14 (D7), U1.11 ((PCINT23/AIN1)PD7)
/LCD_EN: DS1.6 (E), U1.25 ((PCINT10/ADC2)PC2)
/LCD_RS: DS1.4 (RS), U1.24 ((PCINT9/ADC1)PC1)
/MISO: J3.1, U4.1
/MOSI: J3.4, U4.6
/PB3: U1.15 ((PCINT3/OC2A/MOSI)PB3), U4.5
/PB4: U1.16 ((PCINT4/MISO)PB4), U4.2
/RST: J3.5, U1.29 ((PCINT14/~RESET~)PC6)
/RX: R13.2, U1.30 ((PCINT16/RXD)PD0)
/RXD_CAN: U6.4 (RX_CAN), U7.2 (RXCAN)
/SCK: J3.3
/SCL: R2.1, U1.28 ((PCINT13/SCL/ADC5)PC5), U2.6 (SCL)
/SDA: R1.1, U1.27 ((PCINT12/SDA/ADC4)PC4), U2.5 (SDA)
/TX: D6.2 (K), R10.2, R14.1, U1.31 ((PCINT17/TXD)PD1)
/TXD_CAN: U6.1 (TX_CAN), U7.1 (TXCAN)
/XTAL1: C2.1, U1.7 ((PCINT6/XTAL1/TOSC1)PB6), Y1.1
/XTAL2: C5.1, U1.8 ((PCINT7/XTAL2/TOSC2)PB7), Y1.2
/XTAL3: U2.1 (X1), Y2.1
/XTAL4: U2.2 (X2), Y2.2
/XTAL5: C12.1, U7.7 (OSC2), Y3.1
/XTAL6: C14.1, U7.8 (OSC1), Y3.2
GND: BT1.2 (-), C1.2, C2.2, C3.2, C4.2, C5.2, C6.2, C7.2, C8.2, C9.2, C10.2, C11.2, C12.2, C13.2, C14.2, C15.2, C16.2, C17.2, C18.2, C19.2, D3.2 (K), D4.2 (K), D8.2 (K), DS1.1 (VSS), DS1.5 (R/W), J1.2, J2.3, J3.6, Q1.3 (E), Q2.3 (E), R6.2, R17.1, R20.1, RV1.1, U1.3 (GND), U1.5 (GND), U1.20 (AREF), U1.21 (GND), U2.4 (GND), U3.2 (GND), U5.2, U6.2 (Vss), U7.9 (Vss), U8.5 (GND), U9.1 (GND)
unnamed: C3.1, U1.18 (AVCC)
unnamed: C6.1, C7.1, D1.2 (K), U3.1 (IN), U9.3 (VI)
unnamed: C11.1, R8.1
unnamed: C13.1, R9.1
unnamed: D1.1 (A), J1.1
unnamed: D2.1 (A), Q1.2 (C), R4.1, RLY1.3
unnamed: D3.1 (A), R5.1
unnamed: D4.1 (A), R7.1
unnamed: D5.1 (A), R12.1
unnamed: D6.1 (A), R15.1
unnamed: D7.1 (A), R16.1
unnamed: D7.2 (K), R13.1, U8.1 (RO)
unnamed: D8.1 (A), R21.1
unnamed: DS1.3 (VO), RV1.2
unnamed: DS1.16 (LED-), R6.1
unnamed: J2.4, R7.2, RLY1.1
unnamed: Q1.1 (B), R3.2
unnamed: Q2.1 (B), R10.1
unnamed: Q2.2 (C), R11.1, U8.2 (~RE~), U8.3 (DE)
unnamed: R14.2, U8.4 (DI)
unnamed: R17.2, U6.8 (Rs)

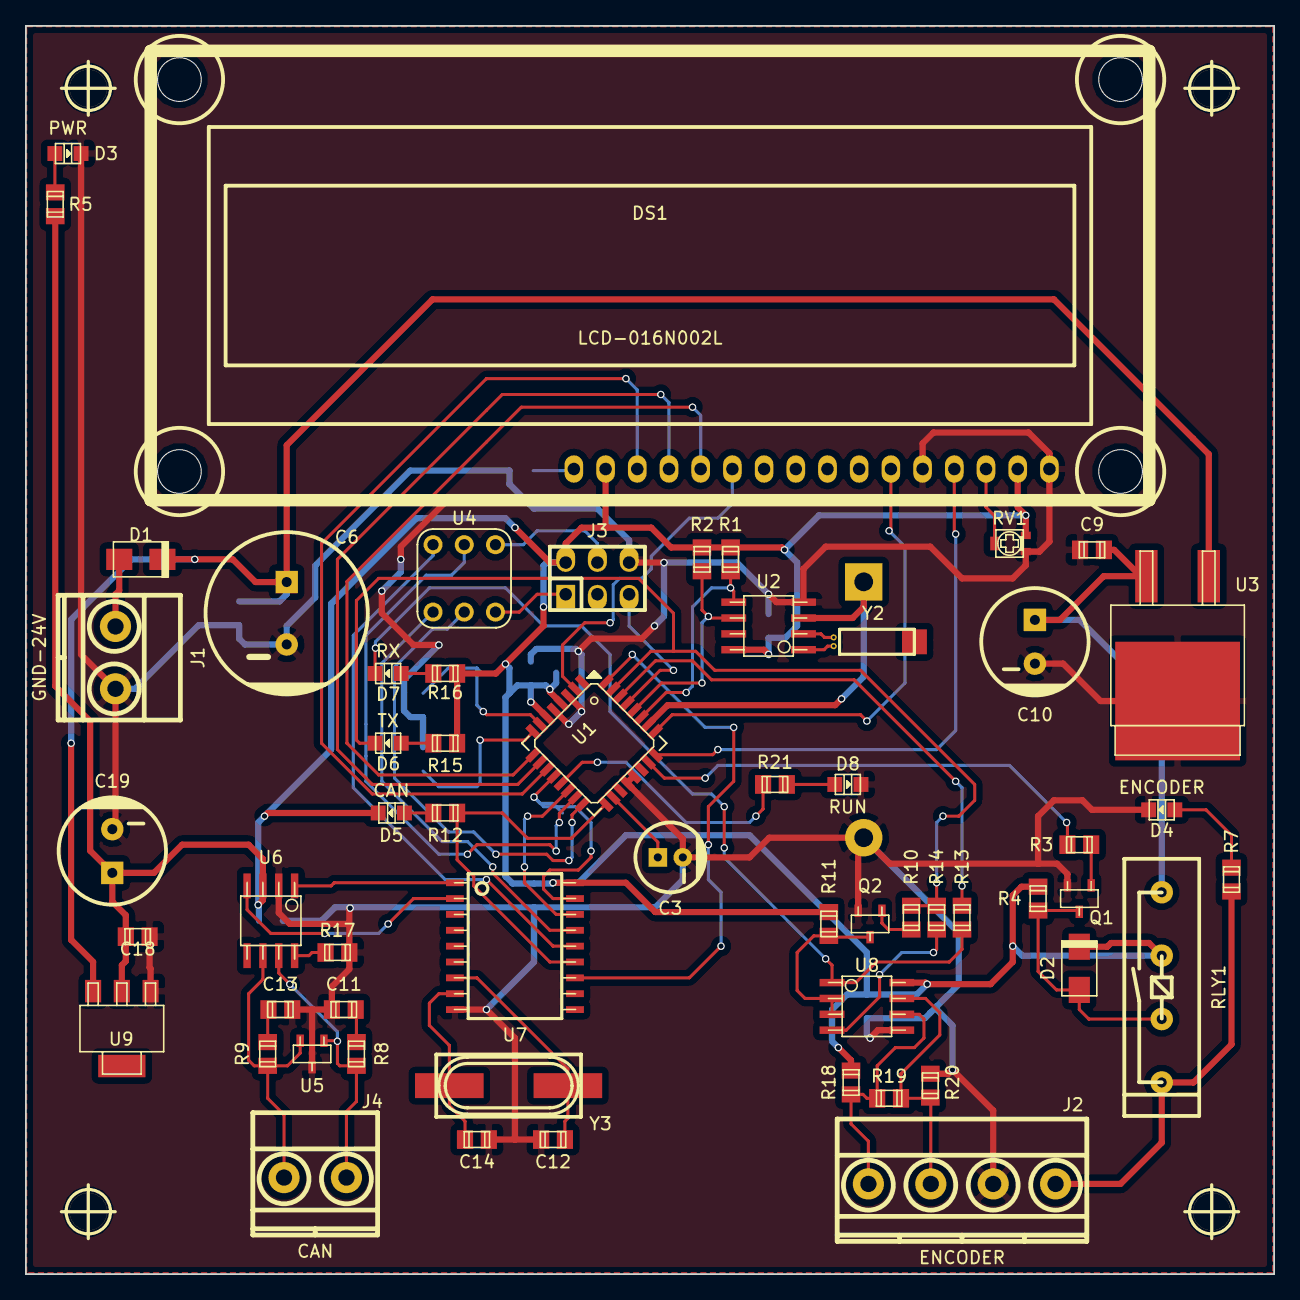
[picture p19: board encoder.kicad_pcb from above]

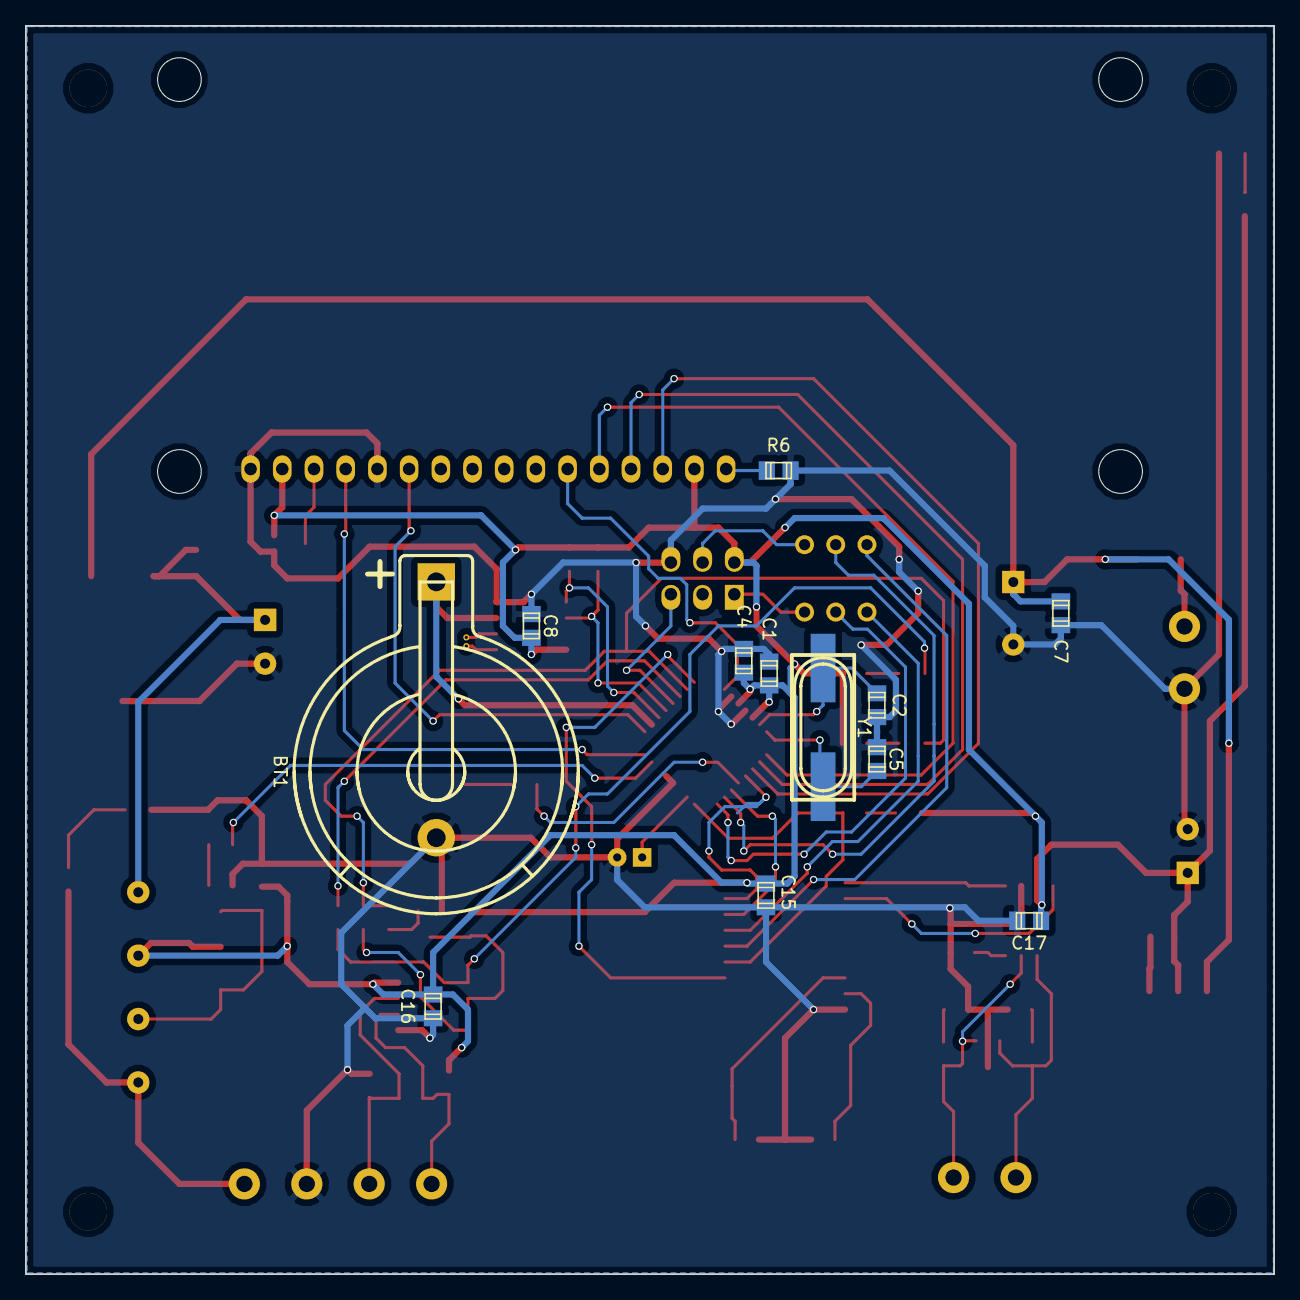
[picture p20: board encoder.kicad_pcb from below]

Board: 2 copper layers, 100.0 x 100.0 mm, 74 parts (12 on the bottom side), 60 nets.

Other parts of the board:
hole_3mm, hole_3mm#2, hole_3mm#3, hole_3mm#4: VAL**; hole_3mm
