cukier/Encoder/src/microchip/heart_beat.h

/*
 * heart_beat.h
 *
 *  Created on: 11 de jul de 2017
 *      Author: cuki
 */

#ifndef SRC_MICROCHIP_HEART_BEAT_H_
#define SRC_MICROCHIP_HEART_BEAT_H_

#include <stdint.h>
#include <stdbool.h>

enum tempos_e {
	HEART_BEAT_RAPIDO = 40000, HEART_BEAT_MEDIO = 10000, HEART_BEAT_LENTO = 0
};

#endif /* SRC_MICROCHIP_HEART_BEAT_H_ */
