cukier/Encoder/src/atmel/uart.h

#ifndef UART_H
#define UART_H

#include "sys.h"

#include <stdint.h>
#include <stdbool.h>
#include <stdarg.h>

#ifdef __AVR__
#include <avr/io.h>
#endif

#ifndef UART_TX_BUFFER_SIZE
#define UART_TX_BUFFER_SIZE		32
#endif

#ifndef UART_RX_BUFFER_SIZE
#define UART_RX_BUFFER_SIZE		32
#endif

void uart_init(void);
uint16_t uart_get_rx_size(void);
uint16_t uart_get_tx_size(void);
void uart_send(uint8_t *data, uint16_t size);
void uart_printf(char *format, ...);
uint16_t uart_get(uint8_t *data, uint16_t size);

#endif // UART_H 
