cukier/Encoder/src/atmel/sys.h

/*
 * sys.h
 *
 *  Created on: 29 de jun de 2017
 *      Author: cuki
 */

#ifndef SRC_SYS_H_
#define SRC_SYS_H_

#define F_CPU				16000000ULL
#define BAUD				19200
#define USE_2X

#endif /* SRC_SYS_H_ */
