cukier/Encoder/src/atmel/lcd.h

/*
 * lcd.h
 *
 * Created: 21/04/2017 11:25:11
 *  Author: cuki
 *	
 */ 


#ifndef LCD_H
#define LCD_H

#include "sys.h"

#include <avr/io.h>
#include <stdint.h>
#include <stdbool.h>
#include <stdarg.h>

#define LCD_DDR		DDRD
#define LCD_PORT	PORTD
#define D4			PORTD4
#define D5			PORTD5
#define D6			PORTD6
#define D7			PORTD7
#define RS_DDR		DDRC
#define RS_PORT		PORTC
#define RS			PORTC1
#define EN_DDR		DDRC
#define EN_PORT		PORTC
#define EN			PORTC2

void output_bit(uint8_t bit, bool value);
void lcd_putc(char c);
void lcd_puts(char *str);
void lcd_printf(char *format, ...);
void lcd_init();

#endif //LCD_H
