cukier/Encoder/(commit log)

2013-01-07 funcionando para encoder AS4050
2013-03-15 Adicionada sch encoder
    [VERSAO-01.brd, VERSAO-01.sch]
2013-03-19 alterando para 18F45K20
    [encoder.DSN]
2013-03-27 limpando RAM
    [encoder.DSN]
2013-03-27 elevador sim em andamento
    [encoder.DSN]
2013-03-27 elevador sim em construcao
    [encoder.DSN]
2013-08-02 inicio testes encoder + comunicacao i2c
2013-08-02 teste de comunicacao + encoder continua no projeto do elevador....
2014-02-14 testando placa
    [encoder.DSN]
2014-02-17 teste de botoes ok
    [encoder.DSN]
2014-02-25 teste de vida de variavel
    [encoder.DSN]
2014-02-26 quadratura usando timer1
    [encoder.DSN]
2014-08-25 lendo a diferenca de movimento e sentido usando os canais a e b como clocks dos timers 0 e 1
    [VERSAO-01.brd, VERSAO-01.sch, encoder.DSN]
2014-08-26 todo: leitura de encoder de quadratura usando ext ints.
    [encoder.DSN]
2014-08-26 feito com interrupcao
    [encoder.DSN]
2014-08-26 lendo encoder de quadratura e direcao usando interrupcao de mudanca no port_b
    [encoder.DSN]
2014-10-27 decoder para encoder sick DFS60
    [encoder.DSN]
2014-11-03 bug fix: filtragem da interrupcao
    [encoder.DSN]
2017-06-28 esquematico encoder CAN
    [H.sch, encoder.kicad_pcb, encoder.sch]
2017-07-03 placa endcoder
    [encoder.kicad_pcb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]
2017-07-04 sim sick.c sick.h
    [encoder.DSN]
2017-07-04 lcd e heart_beat
    [encoder.DSN, encoder.kicad_pcb, encoder.sch]
2017-07-04 lende posicao e mostrando lcd
    [encoder.DSN]
2017-07-04 regulador tensao d2pak
    [encoder.kicad_pcb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]
2017-07-06 correcao rele alimentacao encoder
    [encoder.kicad_pcb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]
2017-07-06 nova bibliotaca uart
    [encoder.DSN]
2017-07-06 nova biblioteca uart
2017-07-10 encoder serial
    [encodera.DSN, microchip.kicad_pcb, microchip.sch]
2017-07-11 heart beat Signed-off-by: cuki2 <mauricio@krebs.com.br>
    [encodera.DSN]
2017-07-24 placa microchip
    [microchip-B.Cu.gbr, microchip-B.Mask.gbr, microchip-B.Paste.gbr, microchip-B.SilkS.gbr, microchip-Dwgs.User.gbr, microchip-Edge.Cuts.gbr, microchip-F.Cu.gbr, microchip-F.Mask.gbr]
